mallewski/TaupunktLueftung/docs/1747229085418.jpg

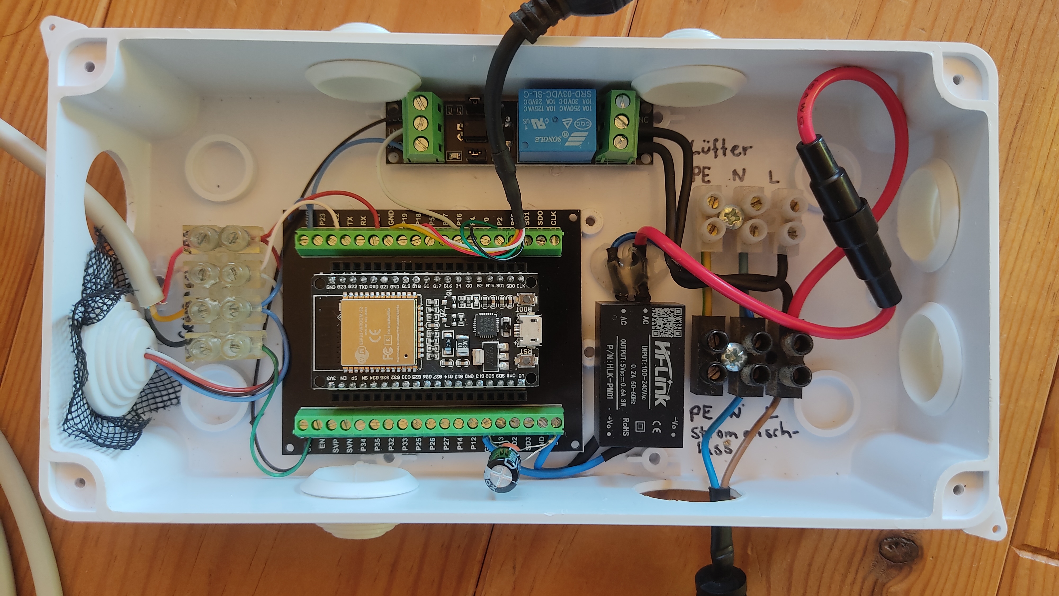
docs/1747229085418.jpg
