mallewski/TaupunktLueftung/(threads)

Thread 6 (2025-04-05):

Projektstruktur modularisieren für Plattform-Portierung

mallewski, 2025-04-05:
Ziel: Vorbereitung auf spätere Portierung des Projekts auf andere Plattformen wie z. B. ESP8266, ESP32-S3, Raspberry Pi Pico W etc. Trennung von Plattform-spezifischem Code, Webinterface & MQTT-Handling

Vorschläge für Refactoring / Modularisierung:

1. MQTT-Client abstrahieren (Interface / Wrapper)

Ziel: Plattformunabhängige MQTT-Schnittstelle

Aktuell stark an PubSubClient gebunden

Idee: Wrapper-Klasse MQTTClientWrapper o. ä.

z. B. mqtt.publish(topic, payload, retained)

mqtt.setCallback(fn)

Intern entscheidet die Klasse, ob PubSubClient o. ä. verwendet wird

Vorteil: Ersetzbar durch andere Bibliotheken (z. B. Async-MQTT, MQTT over TLS, etc.)

2. Webinterface auslagern

Trennung von Backend (Logik, Sensoren) und Frontend (HTML/CSS/JS)

Option A: HTML/JS in externe Dateien und über SPIFFS oder LittleFS laden

Option B: Web-UI komplett extern hosten (für Geräte ohne viel Speicher)

Vorteil:

kleinere Firmware

bessere Wartbarkeit (Frontend separat pflegbar)

evtl. Integration mit modernem JS-Tooling (Webpack, Vue, etc.)

3. Plattform-Checks einbauen

Makros wie #if defined(ESP8266) oder ARDUINO_ARCH_ESP32

Ziel: gezielte Hardware-Kompatibilität

Beispiel: unterschiedliche Pins, unterschiedliche Sensor-Ansteuerung

Langfristiges Ziel: "Plattform-Plugin-System"

Mögliche Klassenstruktur

class SensorManager {
  void begin();
  void readAll();
  float getTempInnen();
  float getHumidityAussen();
  ...
};

class MQTTManager {
  void connect();
  void publishDiscovery();
  void publishState(...);
  void loop();
};

Nutzen

Bessere Wartbarkeit

Einfachere Portierung auf andere Plattformen

Trennung von Verantwortlichkeiten (SRP – Single Responsibility Principle)

Zukunftssicheres Projekt für Langzeitpflege oder Open-Source-Veröffentlichung
