mallewski/TaupunktLueftung/TaupunktLueftung.ino

#include <Wire.h>
#include <WiFi.h>
#include <WebServer.h>
#include <Preferences.h>
#include <Adafruit_SHT31.h>
#include <PubSubClient.h>
#include <time.h>
#include <Update.h>
#include "secrets.h"
#include <WiFiManager.h>
#include <ESPmDNS.h>
#include <esp_netif.h> 
#include <esp_ota_ops.h>
#include <esp_partition.h>

struct Akkumulator;

// Explizite Forward-Declarations: Bei einer .ino-Datei dieser Größe mit
// mehreren großen Raw-String-Literalen (R"rawliteral(...)") für JS/CSS/HTML
// kann Arduinos automatische Prototyp-Erkennung (ctags-basiert, versteht
// Raw-Strings nicht wirklich) vereinzelt "durcheinanderkommen" und einzelne
// spätere Funktionsdefinitionen nicht mehr als solche erkennen. Explizite
// Deklarationen hier machen das unabhängig davon zuverlässig.
String getDashboardHtml();
String getSettingsHtml();
String getFirmwareModalHtml();
void prepareForFirmwareUpdate();

// DebugKategorie muss VOR den Funktionen bekannt sein, die sie als Parameter
// nutzen (debugKategorieAktiv/debugPush) - sonst scheitert Arduinos
// automatische Prototyp-Erkennung, da sie ihre Prototypen ganz oben in der
// Datei einfügt, an einer Stelle vor der eigentlichen enum-Definition weiter
// unten im Code.
enum DebugKategorie { KAT_SENSOR, KAT_MQTT, KAT_CHARTDATA, KAT_DIAG, KAT_AUTH };
bool debugKategorieAktiv(DebugKategorie kat);
void debugPush(DebugKategorie kat, String msg);

//Flash löschen !! löscht ALLE gespeicherten Daten im NVS (inkl. WiFi und Preferences)
//#define DEBUG_ERASE_NVS   // aktivieren zum Löschen des Flash/NVS 
#ifdef DEBUG_ERASE_NVS
#include "nvs_flash.h"
#endif

//Debugging
bool debugMQTT = false; // Debug für MQTT Discovery

//Parameter
#define NAME "TaupunktLueftung"
#define DEFAULT_HOSTNAME "TaupunktLueftung"
String hostname = DEFAULT_HOSTNAME;
#define FIRMWARE_VERSION "v4.3"

// Automatischer Cache-Buster für /style.css und /script.js, unabhängig von
// FIRMWARE_VERSION: __DATE__/__TIME__ sind Standard-C++-Makros, die der
// Compiler bei JEDEM Kompiliervorgang automatisch mit Datum/Uhrzeit des
// Builds füllt - dadurch ändert sich der Cache-Buster garantiert bei jedem
// einzelnen Flash, auch wenn FIRMWARE_VERSION mal vergessen wird
// hochzuzählen (wie zuletzt geschehen: CSS/JS blieben dadurch trotz
// geänderter Firmware im Browser-Cache hängen, u.a. Ursache für das
// beobachtete "Zeitraum springt zurück"-Verhalten).
#define BUILD_STAMP __DATE__ "-" __TIME__
#define RELAY_LED_PIN 16
#define STATUS_GREEN_PIN 2
#define STATUS_RED_PIN 18
#define STATUS_YELLOW_PIN 19
#define SENSORZYKLUS_MS 5000

//Frimware-Update
bool firmwareUpdateSuccess = false;
bool mqttAktivVorUpdate = false;
bool firmwareUploadAuthorized = false; // wird pro Upload-Request in UPLOAD_FILE_START gesetzt

//Umschaltung zwischen DHT22 (Pin17) und SHT31 für Sensor Außen
#define SENSOR_TYP_AUSSEN_SHT31  // auskommentieren für DHT22
#ifdef SENSOR_TYP_AUSSEN_SHT31
Adafruit_SHT31 shtAussen = Adafruit_SHT31();
#else
#include <DHT.h>
#define DHTPIN 17
#define DHTTYPE DHT22
DHT dht(DHTPIN, DHTTYPE);
#endif

Preferences prefs;
WebServer server(80);
WiFiClient espClient;
PubSubClient mqttClient(espClient);
Adafruit_SHT31 shtInnen = Adafruit_SHT31();

char configUsername[32] = "admin"; // Default; über Einstellungen änderbar (dann in NVS gespeichert)
char configPassword[64] = CONFIG_PASSWORD; // Default aus secrets.h; über Einstellungen änderbar (dann in NVS gespeichert)

bool sensorFehlerInnen = false;
bool sensorFehlerAussen = false;
unsigned long sensorFehlerSeit = 0; // 0 = kein Fehler aktiv; Fail-Safe-Timer (kostet nur 4 Byte RAM)

// Wie lange darf ein Sensorfehler andauern, bevor die Lüftung zwangsweise
// abgeschaltet wird? Kurze Aussetzer (I2C-Hänger etc.) werden dank Re-Init
// in aktualisiereSensoren() meist schon im selben 5s-Zyklus behoben, daher
// reicht eine kurze Gnadenfrist, um unnötiges Relais-Takten zu vermeiden.
#define SENSOR_FAILSAFE_MS (15UL * 1000UL)

// Mindestabstand zwischen zwei automatischen MQTT-Verbindungsversuchen aus
// loop() heraus (handleMQTT()). Ohne diese Bremse würde reconnectMQTT() bei
// nicht erreichbarem Broker bei JEDEM loop()-Durchlauf erneut blockierend
// versuchen zu verbinden und dabei die Weboberfläche (server.handleClient()
// kommt in loop() erst danach dran) am Stück lahmlegen.
#define MQTT_RECONNECT_INTERVAL_MS 5000UL
unsigned long letzterMqttVersuch = 0;

char mqttServer[64] = "";     // leer oder z.B. "192.168.1.100"
int mqttPort = 1883;          // Standard-MQTT-Port
char mqttUser[32] = "";
char mqttPassword[64] = "";

String mqttTempInnen = "sensors/temp_innen";
String mqttHygroInnen = "sensors/hygro_innen";
String mqttTempAussen = "sensors/temp_aussen";
String mqttHygroAussen = "sensors/hygro_aussen";
String mqttPublishPrefix = "taupunktlueftung/";
String mqttDiscoveryPrefix = "homeassistant/";

bool mqttAktiv = false;
String modus_innen = "hardware";
String modus_aussen = "hardware";
bool updateModeActive = false;
bool schutzVorAuskuehlungAktiv = false;
bool schutzVorAustrocknungAktiv = false;
float minFeuchteInnen = 35.0; // Mindest-RH, z.B. 35 %
float minTempInnen = 12.0; // °C – Beispielwert
float taupunktDifferenzSchwellwert = 4.0;
unsigned long mindestLaufzeit_ms = 2 * 60 * 1000;
unsigned long mindestPause_ms = 5 * 60 * 1000;
unsigned long letzteAktivierung = 0;
unsigned long letzteDeaktivierung = 0;
bool konstanteFeuchteAktiv = false;
float zielFeuchteInnen = 45.0;
float hysterese = 2.0; // % RH

float t_in = NAN, rh_in = NAN, td_in = NAN;
float t_out = NAN, rh_out = NAN, td_out = NAN;

float mqtt_t_in = NAN, mqtt_rh_in = NAN;
float mqtt_t_out = NAN, mqtt_rh_out = NAN;

#define HIST_NULL INT16_MIN

int16_t toI16(float v) {
  if (isnan(v) || isinf(v)) return HIST_NULL;
  return (int16_t) round(v * 10.0);
}

// ===== Tier 1: 5s-Auflösung, 1 Stunde =====
#define TIER1_POINTS 720
int16_t t1_td_in[TIER1_POINTS], t1_td_out[TIER1_POINTS], t1_diff[TIER1_POINTS];
int16_t t1_rh_in[TIER1_POINTS], t1_rh_out[TIER1_POINTS];
bool    t1_status[TIER1_POINTS];
int     t1_index = 0;

// ===== Tier 2: 1min-Auflösung, 24 Stunden =====
#define TIER2_POINTS 1440
#define TIER2_INTERVAL_MS 60000UL
int16_t t2_td_in[TIER2_POINTS], t2_td_out[TIER2_POINTS];
int16_t t2_diff_avg[TIER2_POINTS], t2_diff_min[TIER2_POINTS], t2_diff_max[TIER2_POINTS];
int16_t t2_rh_in_avg[TIER2_POINTS], t2_rh_in_min[TIER2_POINTS], t2_rh_in_max[TIER2_POINTS];
int16_t t2_rh_out[TIER2_POINTS], t2_rh_out_min[TIER2_POINTS], t2_rh_out_max[TIER2_POINTS];
bool    t2_status[TIER2_POINTS];
int     t2_index = 0;
unsigned long t2_letzterEintrag = 0;

// ===== Tier 3: 1h-Auflösung, 30 Tage =====
#define TIER3_POINTS 720
#define TIER3_INTERVAL_MS 3600000UL
int16_t t3_td_in[TIER3_POINTS], t3_td_out[TIER3_POINTS];
int16_t t3_diff_avg[TIER3_POINTS], t3_diff_min[TIER3_POINTS], t3_diff_max[TIER3_POINTS];
int16_t t3_rh_in_avg[TIER3_POINTS], t3_rh_in_min[TIER3_POINTS], t3_rh_in_max[TIER3_POINTS];
int16_t t3_rh_out[TIER3_POINTS], t3_rh_out_min[TIER3_POINTS], t3_rh_out_max[TIER3_POINTS];
bool    t3_status[TIER3_POINTS];
int     t3_index = 0;
unsigned long t3_letzterEintrag = 0;

// ===== Akkumulatoren (bleiben float, für präzise Summierung) =====
struct Akkumulator {
  float summe_td_in = 0, summe_td_out = 0, summe_diff = 0;
  float min_diff = 999;
  float max_diff = -999; // wichtig für die positive Schwelle (diff >= Schwellwert schaltet die Lüftung ein);
                          // min_diff bleibt für die negative Schwelle (diff <= -Schwellwert, "Befeuchtend"-Anzeige)
  float summe_rh_in = 0, min_rh_in = 999, max_rh_in = -999;
  float summe_rh_out = 0, min_rh_out = 999, max_rh_out = -999;
  int anzahl = 0;
  bool warAktiv = false;
};
Akkumulator akkuTier2;
Akkumulator akkuTier3;

// ===== Debug-Log fürs Webinterface =====
// Ergänzt die bestehenden Serial-Ausgaben um einen kleinen Ringpuffer im RAM,
// der über die Einstellungsseite abrufbar ist - für Diagnose ohne USB-Kabel/
// seriellen Monitor griffbereit zu haben. Bewusst nur die Kategorien, die
// tatsächlich während einer laufenden Verbindung zum Webinterface auftreten
// können (Boot-Ablauf/WLAN-Verbindungsaufbau passiert VOR dem Start des
// Webservers und wäre dort ohnehin nie zu sehen). Enum-Definition (siehe oben
// bei den Forward-Declarations) und diese Variablen/Funktionen gehören
// zusammen, sind aber aus Compiler-Gründen getrennt.

bool debugModusAktiv = false;
bool debugKatSensor = false;
bool debugKatMqtt = false;
bool debugKatChartdata = false;
bool debugKatDiag = false;
bool debugKatAuth = false;

#define DEBUG_PUFFER_ZEILEN 60
String debugPuffer[DEBUG_PUFFER_ZEILEN];
int debugPufferIndex = 0;
int debugPufferAnzahl = 0; // wie viele Zeilen tatsächlich befüllt sind (< DEBUG_PUFFER_ZEILEN direkt nach dem Boot)

bool debugKategorieAktiv(DebugKategorie kat) {
  if (!debugModusAktiv) return false;
  switch (kat) {
    case KAT_SENSOR:    return debugKatSensor;
    case KAT_MQTT:       return debugKatMqtt;
    case KAT_CHARTDATA: return debugKatChartdata;
    case KAT_DIAG:        return debugKatDiag;
    case KAT_AUTH:        return debugKatAuth;
  }
  return false;
}

// Schreibt zusätzlich zur ohnehin vorhandenen Serial-Ausgabe (unverändert an
// jeder bisherigen Stelle) in den Ringpuffer - aber NUR, wenn Debugmodus und
// die jeweilige Kategorie aktiv sind. So bleibt der kleine Puffer nicht sofort
// von einer einzelnen, sehr häufig feuernden Kategorie (z.B. chartdata)
// zugemüllt, wenn die eigentlich interessiert.
void debugPush(DebugKategorie kat, String msg) {
  if (!debugKategorieAktiv(kat)) return;
  debugPuffer[debugPufferIndex] = getUhrzeit() + " " + msg;
  debugPufferIndex = (debugPufferIndex + 1) % DEBUG_PUFFER_ZEILEN;
  if (debugPufferAnzahl < DEBUG_PUFFER_ZEILEN) debugPufferAnzahl++;
}


String statusText = "Unbekannt";
bool lueftungAktiv = false;
String logEintrag = "";
String letzteUhrzeit = "--:--:--";

String getUhrzeit() {
  struct tm timeinfo;
  if (!getLocalTime(&timeinfo)) return "--:--:--";
  char buf[20];
  strftime(buf, sizeof(buf), "%H:%M:%S", &timeinfo);
  return String(buf);
}

void logEvent(String msg) {
  letzteUhrzeit = getUhrzeit();
  logEintrag = letzteUhrzeit + " - " + msg;
  Serial.println(logEintrag);
}

void setLEDs(bool gruen, bool rot, bool gelb) {
  if (sensorFehlerInnen || sensorFehlerAussen) return; // Fehlerzustand: LEDs werden separat gesteuert
  digitalWrite(STATUS_GREEN_PIN, gruen);
  digitalWrite(STATUS_RED_PIN, rot);
  digitalWrite(STATUS_YELLOW_PIN, gelb);
}

//Taupunktberechnung
float berechneTaupunkt(float T, float RH) {
  float a = (T >= 0) ? 7.5 : 7.6;
  float b = (T >= 0) ? 237.3 : 240.7;
  float sdd = 6.1078 * pow(10, (a * T) / (b + T));
  float dd = sdd * RH / 100.0;
  float v = log10(dd / 6.1078);
  return (b * v) / (a - v);
}

void akkumuliere(Akkumulator &a, float ti, float to, float diff, float ri, float ro, bool aktiv) {
  a.summe_td_in += ti;
  a.summe_td_out += to;
  a.summe_diff += diff;
  a.min_diff = min(a.min_diff, diff);
  a.max_diff = max(a.max_diff, diff);
  a.summe_rh_in += ri;
  a.min_rh_in = min(a.min_rh_in, ri);
  a.max_rh_in = max(a.max_rh_in, ri);
  a.summe_rh_out += ro;
  a.min_rh_out = min(a.min_rh_out, ro);
  a.max_rh_out = max(a.max_rh_out, ro);
  a.anzahl++;
  if (aktiv) a.warAktiv = true;
}

void historieAktualisieren() {
  float diff = td_in - td_out;
  unsigned long jetzt = millis();

  t1_td_in[t1_index] = toI16(td_in);
  t1_td_out[t1_index] = toI16(td_out);
  t1_diff[t1_index] = toI16(diff);
  t1_rh_in[t1_index] = toI16(rh_in);
  t1_rh_out[t1_index] = toI16(rh_out);
  t1_status[t1_index] = lueftungAktiv;
  t1_index = (t1_index + 1) % TIER1_POINTS;

  akkumuliere(akkuTier2, td_in, td_out, diff, rh_in, rh_out, lueftungAktiv);

  if (jetzt - t2_letzterEintrag >= TIER2_INTERVAL_MS && akkuTier2.anzahl > 0) {
    t2_letzterEintrag = jetzt;
    float avg_ti = akkuTier2.summe_td_in / akkuTier2.anzahl;
    float avg_to = akkuTier2.summe_td_out / akkuTier2.anzahl;
    float avg_diff = akkuTier2.summe_diff / akkuTier2.anzahl;
    float avg_ri = akkuTier2.summe_rh_in / akkuTier2.anzahl;
    float avg_ro = akkuTier2.summe_rh_out / akkuTier2.anzahl;

    t2_td_in[t2_index] = toI16(avg_ti);
    t2_td_out[t2_index] = toI16(avg_to);
    t2_diff_avg[t2_index] = toI16(avg_diff);
    t2_diff_min[t2_index] = toI16(akkuTier2.min_diff);
    t2_diff_max[t2_index] = toI16(akkuTier2.max_diff);
    t2_rh_in_avg[t2_index] = toI16(avg_ri);
    t2_rh_in_min[t2_index] = toI16(akkuTier2.min_rh_in);
    t2_rh_in_max[t2_index] = toI16(akkuTier2.max_rh_in);
    t2_rh_out[t2_index] = toI16(avg_ro);
    t2_rh_out_min[t2_index] = toI16(akkuTier2.min_rh_out);
    t2_rh_out_max[t2_index] = toI16(akkuTier2.max_rh_out);
    t2_status[t2_index] = akkuTier2.warAktiv;
    t2_index = (t2_index + 1) % TIER2_POINTS;

    akkumuliere(akkuTier3, avg_ti, avg_to, avg_diff, avg_ri, avg_ro, akkuTier2.warAktiv);
    akkuTier3.min_diff = min(akkuTier3.min_diff, akkuTier2.min_diff);
    akkuTier3.max_diff = max(akkuTier3.max_diff, akkuTier2.max_diff);
    akkuTier3.min_rh_in = min(akkuTier3.min_rh_in, akkuTier2.min_rh_in);
    akkuTier3.max_rh_in = max(akkuTier3.max_rh_in, akkuTier2.max_rh_in);
    akkuTier3.min_rh_out = min(akkuTier3.min_rh_out, akkuTier2.min_rh_out);
    akkuTier3.max_rh_out = max(akkuTier3.max_rh_out, akkuTier2.max_rh_out);

    akkuTier2 = Akkumulator();

    if (jetzt - t3_letzterEintrag >= TIER3_INTERVAL_MS && akkuTier3.anzahl > 0) {
      t3_letzterEintrag = jetzt;
      t3_td_in[t3_index] = toI16(akkuTier3.summe_td_in / akkuTier3.anzahl);
      t3_td_out[t3_index] = toI16(akkuTier3.summe_td_out / akkuTier3.anzahl);
      t3_diff_avg[t3_index] = toI16(akkuTier3.summe_diff / akkuTier3.anzahl);
      t3_diff_min[t3_index] = toI16(akkuTier3.min_diff);
      t3_diff_max[t3_index] = toI16(akkuTier3.max_diff);
      t3_rh_in_avg[t3_index] = toI16(akkuTier3.summe_rh_in / akkuTier3.anzahl);
      t3_rh_in_min[t3_index] = toI16(akkuTier3.min_rh_in);
      t3_rh_in_max[t3_index] = toI16(akkuTier3.max_rh_in);
      t3_rh_out[t3_index] = toI16(akkuTier3.summe_rh_out / akkuTier3.anzahl);
      t3_rh_out_min[t3_index] = toI16(akkuTier3.min_rh_out);
      t3_rh_out_max[t3_index] = toI16(akkuTier3.max_rh_out);
      t3_status[t3_index] = akkuTier3.warAktiv;
      t3_index = (t3_index + 1) % TIER3_POINTS;
      akkuTier3 = Akkumulator();
    }
  }
}

void aktualisiereSensoren() {
  // Innen
  if (modus_innen == "mqtt" && mqttAktiv) {
    t_in = mqtt_t_in;
    rh_in = mqtt_rh_in;
  } else {
    t_in = shtInnen.readTemperature();
    rh_in = shtInnen.readHumidity();

    if (isnan(t_in) || isnan(rh_in)) {
      Serial.println("SHT31 innen liefert NAN – versuche Re-Init...");
      debugPush(KAT_SENSOR, "SHT31 innen liefert NAN – versuche Re-Init...");
      if (shtInnen.begin(0x44)) {
        delay(20);
        float temp = shtInnen.readTemperature();
        float hum = shtInnen.readHumidity();
        if (!isnan(temp) && !isnan(hum)) {
          t_in = temp;
          rh_in = hum;
          Serial.println("SHT31 innen Re-Init erfolgreich.");
          debugPush(KAT_SENSOR, "SHT31 innen Re-Init erfolgreich.");
        } else {
          Serial.println("SHT31 innen Re-Init fehlgeschlagen (Werte weiterhin NAN).");
          debugPush(KAT_SENSOR, "SHT31 innen Re-Init fehlgeschlagen (Werte weiterhin NAN).");
        }
      } else {
        Serial.println("SHT31 innen Re-Init fehlgeschlagen (begin() false).");
        debugPush(KAT_SENSOR, "SHT31 innen Re-Init fehlgeschlagen (begin() false).");
      }
    }
  }

#ifdef SENSOR_TYP_AUSSEN_SHT31
  // Außen – SHT31
  if (modus_aussen == "mqtt" && mqttAktiv) {
    t_out = mqtt_t_out;
    rh_out = mqtt_rh_out;
  } else {
    t_out = shtAussen.readTemperature();
    rh_out = shtAussen.readHumidity();

    if (isnan(t_out) || isnan(rh_out)) {
      Serial.println("SHT31 außen liefert NAN – versuche Re-Init...");
      debugPush(KAT_SENSOR, "SHT31 außen liefert NAN – versuche Re-Init...");
      if (shtAussen.begin(0x45)) {
        delay(20);
        t_out = shtAussen.readTemperature();
        rh_out = shtAussen.readHumidity();
        Serial.println("SHT31 außen Re-Init erfolgreich.");
        debugPush(KAT_SENSOR, "SHT31 außen Re-Init erfolgreich.");
      } else {
        Serial.println("SHT31 außen Re-Init fehlgeschlagen.");
        debugPush(KAT_SENSOR, "SHT31 außen Re-Init fehlgeschlagen.");
      }
    }
  }
#else
  // Außen – DHT22
  if (modus_aussen == "mqtt" && mqttAktiv) {
    t_out = mqtt_t_out;
    rh_out = mqtt_rh_out;
  } else {
    t_out = dht.readTemperature();
    rh_out = dht.readHumidity();

    if (isnan(t_out) || isnan(rh_out)) {
      Serial.println("DHT22 liefert NAN – versuche Re-Init...");
      debugPush(KAT_SENSOR, "DHT22 liefert NAN – versuche Re-Init...");
      dht.begin();
      delay(100);
      float temp = dht.readTemperature();
      float hum = dht.readHumidity();
      if (!isnan(temp) && !isnan(hum)) {
        t_out = temp;
        rh_out = hum;
        Serial.println("DHT22 Re-Init erfolgreich.");
        debugPush(KAT_SENSOR, "DHT22 Re-Init erfolgreich.");
      } else {
        Serial.println("DHT22 Re-Init fehlgeschlagen (Werte weiterhin NAN).");
        debugPush(KAT_SENSOR, "DHT22 Re-Init fehlgeschlagen (Werte weiterhin NAN).");
      }
    }
  }
#endif

  // Fehlerstatus getrennt prüfen
  sensorFehlerInnen = isnan(t_in) || isnan(rh_in);
  sensorFehlerAussen = isnan(t_out) || isnan(rh_out);

  if (sensorFehlerInnen) {
    td_in = NAN;
    Serial.println("Sensorfehler INNEN erkannt!");
    debugPush(KAT_SENSOR, "Sensorfehler INNEN erkannt!");
  } else {
    td_in = berechneTaupunkt(t_in, rh_in);
  }

  if (sensorFehlerAussen) {
    td_out = NAN;
    Serial.println("Sensorfehler AUSSEN erkannt!");
    debugPush(KAT_SENSOR, "Sensorfehler AUSSEN erkannt!");
  } else {
    td_out = berechneTaupunkt(t_out, rh_out);
  }

  publishAllStates();
}

void steuerlogik() {
  unsigned long jetzt = millis();

  // === 0. Fail-Safe bei Sensorausfall ===
  if (isnan(td_in) || isnan(td_out) || isnan(rh_in) || isnan(t_in)) {
    if (sensorFehlerSeit == 0) sensorFehlerSeit = jetzt;

    if (jetzt - sensorFehlerSeit >= SENSOR_FAILSAFE_MS) {
      if (lueftungAktiv) {
        digitalWrite(RELAY_LED_PIN, LOW);
        lueftungAktiv = false;
        letzteDeaktivierung = jetzt;
        logEvent("Lüftung zwangsweise deaktiviert - Sensorfehler (Fail-Safe)");
      }
      statusText = "Sensorfehler - Lüftung aus (Fail-Safe)";
    } else {
      statusText = "Sensorfehler - warte auf Fail-Safe-Abschaltung";
    }

    historieAktualisieren();
    publishAllStates();
    return;
  }
  sensorFehlerSeit = 0;

  float diff = td_in - td_out;

  // === 1. Austrocknungsschutz ===
  if (schutzVorAustrocknungAktiv && rh_in < minFeuchteInnen) {
    if (lueftungAktiv) {
      digitalWrite(RELAY_LED_PIN, LOW);
      lueftungAktiv = false;
      letzteDeaktivierung = jetzt;
      logEvent("Lüftung deaktiviert – Austrocknungsschutz");
    }
    setLEDs(false, false, true);
    statusText = "Austrocknungsschutz – Lüftung aus";
    historieAktualisieren();  
    publishAllStates();
    return;
  }

  // === 2. Temperaturschutz ===
  if (schutzVorAuskuehlungAktiv && t_in < minTempInnen) {
    if (lueftungAktiv) {
      digitalWrite(RELAY_LED_PIN, LOW);
      lueftungAktiv = false;
      letzteDeaktivierung = jetzt;
      logEvent("Lüftung deaktiviert – Temperaturschutz");
    }
    setLEDs(false, false, true);
    statusText = "Temperaturschutz – Lüftung aus";
    historieAktualisieren();  
    publishAllStates();
    return;
  }

  // === 3. Feuchteregelung aktiv? ===
  if (konstanteFeuchteAktiv) {
    float rhSoll_min = zielFeuchteInnen - hysterese;
    float rhSoll_max = zielFeuchteInnen + hysterese;

    if (rh_in < rhSoll_min && td_out > td_in + 1.0) {
      digitalWrite(RELAY_LED_PIN, HIGH);
      if (!lueftungAktiv) {
        letzteAktivierung = jetzt;
        logEvent("Lüftung aktiviert – Befeuchtung (Regelung)");
      }
      lueftungAktiv = true;
      setLEDs(false, true, false);
      statusText = "Regelung: Befeuchten (Lüftung AN)";
    } 
    else if (rh_in > rhSoll_max && td_out < td_in - 1.0) {
      digitalWrite(RELAY_LED_PIN, HIGH);
      if (!lueftungAktiv) {
        letzteAktivierung = jetzt;
        logEvent("Lüftung aktiviert – Entfeuchtung (Regelung)");
      }
      lueftungAktiv = true;
      setLEDs(true, false, false);
      statusText = "Regelung: Entfeuchten (Lüftung AN)";
    } 
    else {
      if (lueftungAktiv) {
        digitalWrite(RELAY_LED_PIN, LOW);
        letzteDeaktivierung = jetzt;
        logEvent("Lüftung deaktiviert – RH im Zielbereich");
      }
      lueftungAktiv = false;
      setLEDs(false, false, true);
      statusText = "Regelung: RH im Zielbereich – Lüftung AUS";
    }

    historieAktualisieren();
    publishAllStates();
    return;
  }

  // === 4. Klassische Taupunktlogik ===
  bool darfEinschalten = (diff >= taupunktDifferenzSchwellwert) &&
                         (!lueftungAktiv) &&
                         (jetzt - letzteDeaktivierung >= mindestPause_ms);

  bool darfAusschalten = (diff < taupunktDifferenzSchwellwert) &&
                         (lueftungAktiv) &&
                         (jetzt - letzteAktivierung >= mindestLaufzeit_ms);

  if (darfEinschalten) {
    digitalWrite(RELAY_LED_PIN, HIGH);
    lueftungAktiv = true;
    letzteAktivierung = jetzt;
    logEvent("Lüftung aktiviert (Taupunktdifferenz)");
  }

  if (darfAusschalten) {
    digitalWrite(RELAY_LED_PIN, LOW);
    lueftungAktiv = false;
    letzteDeaktivierung = jetzt;
    logEvent("Lüftung deaktiviert (Taupunktdifferenz)");
  }

  if (lueftungAktiv) {
    setLEDs(true, false, false);
    statusText = "Trocknend – Lüftung aktiv";
  } else if (diff <= -taupunktDifferenzSchwellwert) {
    setLEDs(false, true, false);
    statusText = "Befeuchtend – Lüftung aus";
  } else {
    setLEDs(false, false, true);
    statusText = "Neutral – Lüftung aus";
  }

  historieAktualisieren();
  publishAllStates();
}

//MQTT Empfang
void mqttCallback(char* topic, byte* payload, unsigned int length) {
  String val;
  for (unsigned int i = 0; i < length; i++) val += (char)payload[i];
  Serial.println("MQTT RX: topic='" + String(topic) + "' payload='" + val + "'");
  debugPush(KAT_MQTT, "MQTT RX: topic='" + String(topic) + "' payload='" + val + "'");
  Serial.println("Erwartet mqttTempInnen='" + mqttTempInnen + "'");
  float fval = val.toFloat();
  if (String(topic) == mqttTempInnen) mqtt_t_in = fval;
  if (String(topic) == mqttHygroInnen) mqtt_rh_in = fval;
  if (String(topic) == mqttTempAussen) mqtt_t_out = fval;
  if (String(topic) == mqttHygroAussen) mqtt_rh_out = fval;
}

//MQTT Senden
void publishAllStates() {
  if (!mqttAktiv || !mqttClient.connected()) return;

  mqttClient.publish((mqttPublishPrefix + "temp_innen").c_str(), String(t_in, 1).c_str(), true);
  mqttClient.publish((mqttPublishPrefix + "hygro_innen").c_str(), String(rh_in, 1).c_str(), true);
  mqttClient.publish((mqttPublishPrefix + "taupunkt_innen").c_str(), String(td_in, 1).c_str(), true);

  mqttClient.publish((mqttPublishPrefix + "temp_aussen").c_str(), String(t_out, 1).c_str(), true);
  mqttClient.publish((mqttPublishPrefix + "hygro_aussen").c_str(), String(rh_out, 1).c_str(), true);
  mqttClient.publish((mqttPublishPrefix + "taupunkt_aussen").c_str(), String(td_out, 1).c_str(), true);

  mqttClient.publish((mqttPublishPrefix + "diff").c_str(), String(td_in - td_out, 1).c_str(), true);

  mqttClient.publish((mqttPublishPrefix + "status").c_str(), lueftungAktiv ? "1" : "0", true);

  mqttClient.publish((mqttPublishPrefix + "availability").c_str(), "online", true);

  mqttClient.publish((mqttPublishPrefix + "fehler_innen").c_str(), sensorFehlerInnen ? "1" : "0", true);
  mqttClient.publish((mqttPublishPrefix + "fehler_aussen").c_str(), sensorFehlerAussen ? "1" : "0", true);
}

void publishMQTTDiscovery() {
  if (!mqttClient.connected()) return;
  String deviceID = hostname;

  struct Sensor {
    String id;
    String name;
    String unit;
    String devclass;
    String topic;
    bool binary;
  };

  Sensor sensoren[] = {
    {"tin", "Temperatur Innen", "°C", "temperature", mqttPublishPrefix + "temp_innen", false},
    {"hin", "Luftfeuchte Innen", "%", "humidity", mqttPublishPrefix + "hygro_innen", false},
    {"tdin", "Taupunkt Innen", "°C", "temperature", mqttPublishPrefix + "taupunkt_innen", false},
    {"tout", "Temperatur Außen", "°C", "temperature", mqttPublishPrefix + "temp_aussen", false},
    {"hout", "Luftfeuchte Außen", "%", "humidity", mqttPublishPrefix + "hygro_aussen", false},
    {"tdout", "Taupunkt Außen", "°C", "temperature", mqttPublishPrefix + "taupunkt_aussen", false},
    {"diff", "Taupunkt-Differenz", "°C", "temperature", mqttPublishPrefix + "diff", false},
    {"lueftung", "Lüftung aktiv", "", "", mqttPublishPrefix + "status", true},
    {"fehler_innen", "Sensorfehler Innen", "", "", mqttPublishPrefix + "fehler_innen", true},
    {"fehler_aussen", "Sensorfehler Außen", "", "", mqttPublishPrefix + "fehler_aussen", true}
  };

  for (Sensor s : sensoren) {
    String type = s.binary ? "binary_sensor" : "sensor";
    String configTopic = mqttDiscoveryPrefix + type + "/" + deviceID + "_" + s.id + "/config";

    String payload = "{";
    payload += "\"name\":\"" + s.name + "\",";
    payload += "\"state_topic\":\"" + s.topic + "\",";
    payload += "\"availability_topic\":\"" + mqttPublishPrefix + "availability\",";
    payload += "\"payload_available\":\"online\",\"payload_not_available\":\"offline\",";
    if (!s.unit.isEmpty()) payload += "\"unit_of_measurement\":\"" + s.unit + "\",";
    if (!s.devclass.isEmpty()) payload += "\"device_class\":\"" + s.devclass + "\",";
    if (s.binary) payload += "\"payload_on\":\"1\",\"payload_off\":\"0\",";
    payload += "\"unique_id\":\"" + deviceID + "_" + s.id + "\",";
    payload += "\"device\":{";
    payload += "\"identifiers\":[\"" + deviceID + "\"],";
    payload += "\"name\":\"TaupunktLueftung\",";
    payload += "\"model\":\"ESP32\",";
    payload += "\"manufacturer\":\"DIY\"}";
    payload += "}";
    bool ok = mqttClient.publish(configTopic.c_str(), payload.c_str(), true);
    if (debugMQTT) {
      Serial.println("Sende Discovery an Topic: " + configTopic);
      Serial.println("Payload: " + payload);
      Serial.println(ok ? "Publish erfolgreich" : "Publish FEHLGESCHLAGEN");
    }
  }
  if (debugMQTT) {
    mqttClient.publish("homeassistant/sensor/testsensor/config", 
    "{\"name\":\"TestSensor\",\"state_topic\":\"testsensor/value\",\"unit_of_measurement\":\"°C\",\"device_class\":\"temperature\"}", 
    true);
    mqttClient.publish("testsensor/value", "22.1", true);
  }
}

void loadMQTTSettings() {
  prefs.begin("config", true);
  String serverStr = prefs.getString("mqtt_server", mqttServer);
  String user = prefs.getString("mqtt_user", mqttUser);
  String pass = prefs.getString("mqtt_pass", mqttPassword);
  mqttPort = prefs.getInt("mqtt_port", mqttPort);
  prefs.end();

  serverStr.toCharArray(mqttServer, sizeof(mqttServer));
  user.toCharArray(mqttUser, sizeof(mqttUser));
  pass.toCharArray(mqttPassword, sizeof(mqttPassword));
  mqttClient.setServer(mqttServer, mqttPort);
}

void saveMQTTSettings() {
  prefs.begin("config", false);
  prefs.putString("mqtt_server", mqttServer);
  prefs.putInt("mqtt_port", mqttPort);
  prefs.putString("mqtt_user", mqttUser);
  prefs.putString("mqtt_pass", mqttPassword);
  prefs.end();
}

void loadMQTTTopics() {
  prefs.begin("config", true);
  mqttTempInnen = prefs.getString("mqtt_temp_in", mqttTempInnen);
  mqttHygroInnen = prefs.getString("mqtt_rh_in", mqttHygroInnen);
  mqttTempAussen = prefs.getString("mqtt_temp_out", mqttTempAussen);
  mqttHygroAussen = prefs.getString("mqtt_rh_out", mqttHygroAussen);
  mqttPublishPrefix = prefs.getString("mqtt_pub_prefix", mqttPublishPrefix);
  mqttDiscoveryPrefix = prefs.getString("mqtt_discovery_prefix", mqttDiscoveryPrefix);
  prefs.end();
}

void saveMQTTTopics() {
  prefs.begin("config", false);
  prefs.putString("mqtt_temp_in", mqttTempInnen);
  prefs.putString("mqtt_rh_in", mqttHygroInnen);
  prefs.putString("mqtt_temp_out", mqttTempAussen);
  prefs.putString("mqtt_rh_out", mqttHygroAussen);
  prefs.putString("mqtt_pub_prefix", mqttPublishPrefix);
  prefs.putString("mqtt_discovery_prefix", mqttDiscoveryPrefix);
  prefs.end();
}

void resubscribeMQTTTopics() {
  if (!mqttClient.connected()) return;
  mqttClient.subscribe(mqttTempInnen.c_str());
  mqttClient.subscribe(mqttHygroInnen.c_str());
  mqttClient.subscribe(mqttTempAussen.c_str());
  mqttClient.subscribe(mqttHygroAussen.c_str());
}

void reconnectMQTT() {
  if (!mqttAktiv) return;
  letzterMqttVersuch = millis(); // auch bei manuellem Aufruf (Config speichern, MQTT-Toggle)
                                  // mitzählen, damit direkt danach kein doppelter Auto-Versuch folgt
  while (!mqttClient.connected()) {
    Serial.print("MQTT verbinden mit: "); Serial.println(mqttServer);
    debugPush(KAT_MQTT, "MQTT verbinden mit: " + String(mqttServer));
    if (mqttClient.connect(NAME, mqttUser, mqttPassword, (mqttPublishPrefix + "availability").c_str(), 1, true, "offline" )) {
      delay(500);
      resubscribeMQTTTopics();
      Serial.println("MQTT verbunden.");
      debugPush(KAT_MQTT, "MQTT verbunden.");
      delay(500);
      publishMQTTDiscovery();
      mqttClient.publish("homeassistant/status", "online", true);
      mqttClient.publish((mqttPublishPrefix + "availability").c_str(), "online", true);
    } else {
      Serial.print("MQTT-Verbindung fehlgeschlagen. Code: ");
      Serial.println(mqttClient.state());
      debugPush(KAT_MQTT, "MQTT-Verbindung fehlgeschlagen. Code: " + String(mqttClient.state()));
      break;
    }
  }
  publishAllStates();
}

void handleChartData() {
  // Zeitmessung + Heap-Status für den seriellen Log: damit beim nächsten
  // Auftreten einer langsamen/fehlgeschlagenen Anfrage echte Werte vorliegen,
  // statt weiter zu vermuten, wo die Zeit hingeht.
  unsigned long tStart = millis();
  uint32_t heapVorher = ESP.getFreeHeap();

  String tier = server.hasArg("tier") ? server.arg("tier") : "1";
  // Wie viele der neuesten Punkte tatsächlich gebraucht werden - ohne diesen
  // Parameter (Rückwärtskompatibilität) wird wie bisher der komplette
  // Tier-Puffer gesendet. Vermeidet, dass z.B. für "10 Minuten" trotzdem der
  // komplette 1h-Tier1-Puffer (720 Punkte) übertragen wird, obwohl nur ein
  // Bruchteil davon dargestellt wird - spart sowohl Erzeugungszeit auf dem
  // ESP32 als auch Übertragungszeit übers WLAN.
  int angefordert = server.hasArg("count") ? server.arg("count").toInt() : -1;
  auto f2 = [](int16_t v) {
    return v == HIST_NULL ? String("null") : String(v / 10.0, 1);
  };

  server.setContentLength(CONTENT_LENGTH_UNKNOWN);
  server.send(200, "application/json", "");
  server.sendContent("[");

  int gesendetePunkte = 0;
  int gesendeteBloecke = 0;

  auto sendeTier = [&](int16_t* ti, int16_t* to, int16_t* davg, int16_t* dmin, int16_t* dmax,
                        int16_t* riavg, int16_t* rimin, int16_t* rimax, int16_t* ro, int16_t* romin, int16_t* romax, bool* st, int n, int startIdx) {
    int anzahl = (angefordert > 0 && angefordert < n) ? angefordert : n;
    int versatz = n - anzahl; // Startpunkt so weit nach vorn verschieben, dass nur die letzten "anzahl" Punkte drankommen
    gesendetePunkte = anzahl;

    // Mehrere Punkte zu einem Block bündeln, bevor tatsächlich gesendet wird:
    // Vorher löste JEDER einzelne Punkt einen eigenen server.sendContent()-Aufruf
    // aus - bei bis zu 1440 Punkten also 1440 einzelne TCP-Sendevorgänge mit
    // jeweils vollem Protokoll-Overhead für nur ~135 Bytes Nutzdaten. Das war
    // der Hauptgrund für die spürbar lange Ladezeit. Gleiche Datenmenge,
    // deutlich weniger Einzel-Sendevorgänge.
    const int BLOCK_GROESSE = 40;
    String block = "";
    block.reserve(BLOCK_GROESSE * 170); // vermeidet wiederholtes Nachvergrößern des Blocks selbst

    for (int i = 0; i < anzahl; i++) {
      int idx = (startIdx + versatz + i) % n;
      if (i > 0) block += ",";
      block += "{\"td_in\":" + f2(ti[idx]) + ",\"td_out\":" + f2(to[idx]) + ",";
      block += "\"diff\":" + f2(davg[idx]) + ",\"diff_min\":" + f2(dmin[idx]) + ",\"diff_max\":" + f2(dmax[idx]) + ",";
      block += "\"rh_in\":" + f2(riavg[idx]) + ",\"rh_in_min\":" + f2(rimin[idx]) + ",\"rh_in_max\":" + f2(rimax[idx]) + ",";
      block += "\"rh_out\":" + f2(ro[idx]) + ",\"rh_out_min\":" + f2(romin[idx]) + ",\"rh_out_max\":" + f2(romax[idx]) + ",";
      block += "\"status\":" + String(st[idx] ? 1 : 0) + "}";

      if ((i + 1) % BLOCK_GROESSE == 0 || i == anzahl - 1) {
        server.sendContent(block);
        gesendeteBloecke++;
        block = "";
      }
    }
  };

  if (tier == "2") {
    sendeTier(t2_td_in, t2_td_out, t2_diff_avg, t2_diff_min, t2_diff_max, t2_rh_in_avg, t2_rh_in_min, t2_rh_in_max, t2_rh_out, t2_rh_out_min, t2_rh_out_max, t2_status, TIER2_POINTS, t2_index);
  } else if (tier == "3") {
    sendeTier(t3_td_in, t3_td_out, t3_diff_avg, t3_diff_min, t3_diff_max, t3_rh_in_avg, t3_rh_in_min, t3_rh_in_max, t3_rh_out, t3_rh_out_min, t3_rh_out_max, t3_status, TIER3_POINTS, t3_index);
  } else {
    sendeTier(t1_td_in, t1_td_out, t1_diff, t1_diff, t1_diff, t1_rh_in, t1_rh_in, t1_rh_in, t1_rh_out, t1_rh_out, t1_rh_out, t1_status, TIER1_POINTS, t1_index);
  }

  server.sendContent("]");
  server.sendContent("");

  unsigned long dauerMs = millis() - tStart;
  uint32_t heapNachher = ESP.getFreeHeap();
  int32_t heapDiff = (int32_t)heapNachher - (int32_t)heapVorher;
  Serial.printf("[chartdata] tier=%s count=%d Punkte=%d Bloecke=%d Dauer=%lums FreeHeap vorher=%u nachher=%u Diff=%d\n",
                tier.c_str(), angefordert, gesendetePunkte, gesendeteBloecke, dauerMs, heapVorher, heapNachher, heapDiff);
  debugPush(KAT_CHARTDATA, "tier=" + tier + " count=" + String(angefordert) + " Punkte=" + String(gesendetePunkte) +
            " Bloecke=" + String(gesendeteBloecke) + " Dauer=" + String(dauerMs) + "ms Heap-Diff=" + String(heapDiff));
}

void handleLiveData() {
  String sichereUhrzeit = getUhrzeit();
  sichereUhrzeit.replace("\"", "'");
  String sichererStatus = statusText;
  sichererStatus.replace("\"", "'");

  unsigned long now = millis();
  String timerInfo = "";

  if (!lueftungAktiv && now - letzteDeaktivierung < mindestPause_ms) {
    unsigned long remaining = (mindestPause_ms - (now - letzteDeaktivierung)) / 1000;
    char buffer[6];
    snprintf(buffer, sizeof(buffer), "%lu:%02lu", remaining / 60, remaining % 60);
    timerInfo = String(buffer) + " min Sperre";
  } else if (lueftungAktiv && now - letzteAktivierung < mindestLaufzeit_ms) {
    unsigned long remaining = (mindestLaufzeit_ms - (now - letzteAktivierung)) / 1000;
    char buffer[6];
    snprintf(buffer, sizeof(buffer), "%lu:%02lu", remaining / 60, remaining % 60);
    timerInfo = String(buffer) + " min Mindestlaufzeit";
  }

  auto f1 = [](float val) {
    return isnan(val) || isinf(val) ? "null" : String(val, 1);
  };

  String json = "{";
  json += "\"t_in\":" + f1(t_in) + ",";
  json += "\"rh_in\":" + f1(rh_in) + ",";
  json += "\"t_out\":" + f1(t_out) + ",";
  json += "\"rh_out\":" + f1(rh_out) + ",";
  json += "\"td_in\":" + f1(td_in) + ",";
  json += "\"td_out\":" + f1(td_out) + ",";
  json += "\"zeit\":\"" + sichereUhrzeit + "\",";
  json += "\"status\":\"" + sichererStatus + "\",";
  json += "\"timer\":\"" + timerInfo + "\",";
  json += "\"schwelle\":" + String(taupunktDifferenzSchwellwert, 1) + ",";
  json += "\"feuchteregelungAktiv\":" + String(konstanteFeuchteAktiv ? "true" : "false") + ",";
  json += "\"zielRh\":" + String(zielFeuchteInnen, 1) + ",";
  json += "\"hysterese\":" + String(hysterese, 1);
  json += "}";
  server.send(200, "application/json", json);
}

void redirectToSettings() {
  server.send(200, "text/html", R"rawliteral(
    <html><head><meta charset='UTF-8'>
      <script>
        localStorage.setItem("stayOnSettings", "true");
        window.location.href = "/";
      </script>
    </head><body></body></html>
  )rawliteral");
}

void handleReboot() {
  server.send(200, "text/plain", "Neustart wird durchgeführt...");
  Serial.println("Neustart über Weboberfläche ausgelöst");
  delay(500);
  ESP.restart();
}

void handleWifiReset() {
  server.send(200, "text/plain", "WLAN-Zugangsdaten werden gelöscht, Gerät startet neu...");
  Serial.println("WLAN-Reset über Weboberfläche ausgelöst");
  delay(500);

  WiFiManager wm;
  wm.resetSettings();
  ESP.restart();
}

bool requireAuth() {
  if (!server.authenticate(configUsername, configPassword)) {
    // Nur echte Fehlversuche loggen (Client hat Zugangsdaten mitgeschickt,
    // die aber falsch waren) - nicht die ganz normale allererste Anfrage
    // eines Browsers ohne Authorization-Header, die jeder Seitenaufruf ohne
    // gespeicherte Zugangsdaten zwangsläufig einmal auslöst.
    if (server.hasHeader("Authorization")) {
      debugPush(KAT_AUTH, "Fehlgeschlagener Login-Versuch von " + server.client().remoteIP().toString());
    }
    server.requestAuthentication(BASIC_AUTH, "TaupunktLueftung");
    return false;
  }
  return true;
}

// --- Dashboard --->
// Reines JavaScript (keine <script>-Tags mehr drumherum!): wird über die
// eigene Route /script.js ausgeliefert (siehe handleScriptJS()), statt wie
// früher bei jedem Seitenaufruf komplett inline in handleRoot() eingebettet
// zu werden. Dadurch kann der Browser die Datei cachen (Cache-Control-Header
// in handleScriptJS()) und muss die ca. 20 KB nicht bei jedem Laden neu vom
// ESP32 anfordern - das war der Hauptgrund für die zuletzt spürbar langsamer
// gewordenen Seitenaufrufe.
const char MAIN_SCRIPT_JS[] PROGMEM = R"rawliteral(
      let SCHWELLWERT = 4.0;
      let FEUCHTEREGELUNG_AKTIV = false;
      let ZIEL_RH = 45.0;
      let HYSTERESE = 2.0;
      const COLOR_TD_IN = 'green';
      const COLOR_TD_OUT = 'blue';
      const COLOR_DIFF = 'orange';
      const COLOR_SCHWELL = 'gray';
      const COLOR_STATUS_ON = 'rgba(0,200,0,0.6)';
      const COLOR_STATUS_OFF = 'rgba(0,0,0,0)';
      let chart, chart_humidity, chart_status;
      let chartInitialized = false;

      function getIntervalInSeconds(tier) {
        if (tier === '1') return 5;    // Tier 1: 5 Sekunden
        if (tier === '2') return 60;   // Tier 2: 1 Minute
        if (tier === '3') return 3600; // Tier 3: 1 Stunde
        return 1;
      }
      function formatTime(date, tier) {
        if (tier === '3') {
          return `${String(date.getDate()).padStart(2, '0')}.${String(date.getMonth() + 1).padStart(2, '0')}. ${String(date.getHours()).padStart(2, '0')}:00`;
        } else if (tier === '2') {
          return `${String(date.getHours()).padStart(2, '0')}:${String(date.getMinutes()).padStart(2, '0')}`;
        } else {
          return `${String(date.getHours()).padStart(2, '0')}:${String(date.getMinutes()).padStart(2, '0')}:${String(date.getSeconds()).padStart(2, '0')}`;
        }
      }

      // Maximale Punktzahl, die tatsächlich sinnvoll auf einem Mobil-Bildschirm
      // unterscheidbar ist. Deutlich unter der Pixelbreite eines Telefon-Displays,
      // damit nie mehr als ein Punkt pro Pixel gezeichnet wird.
      const MAX_CHART_POINTS = 300;

      // Verdichtet für die Anzeige weiter, falls mehr Rohpunkte vorliegen, als
      // sinnvoll darstellbar sind - genau nach demselben Prinzip wie die
      // Tier2/Tier3-Speicherung auf dem Gerät selbst (Durchschnitt der
      // Durchschnitte, aber Minimum der Minima / Maximum der Maxima). Das ist
      // rein clientseitig zur Laufzeit, ändert nichts an den gespeicherten
      // Rohdaten auf dem ESP32, und verliert dabei nachweislich KEINEN
      // Extremwert - egal wie oft man diese Verdichtung verschachtelt, bleibt
      // das globale Minimum/Maximum exakt erhalten. Das behebt das "wilde
      // Zickzack" bei sehr vielen Punkten (z.B. 1440 Tier2-Punkte in der
      // 24h-Ansicht), ohne die zugrunde liegende Datenbasis zu verändern.
      function verdichteFuerAnzeige(punkte, effektivesIntervallSek) {
        if (punkte.length <= MAX_CHART_POINTS) {
          return { data: punkte, intervallSek: effektivesIntervallSek };
        }
        const bucketGroesse = Math.ceil(punkte.length / MAX_CHART_POINTS);
        const avg = (bucket, feld) => {
          const werte = bucket.map(p => p[feld]).filter(v => v !== null && v !== undefined);
          return werte.length ? werte.reduce((a, b) => a + b, 0) / werte.length : null;
        };
        const minVon = (bucket, feld) => {
          const werte = bucket.map(p => p[feld]).filter(v => v !== null && v !== undefined);
          return werte.length ? Math.min(...werte) : null;
        };
        const maxVon = (bucket, feld) => {
          const werte = bucket.map(p => p[feld]).filter(v => v !== null && v !== undefined);
          return werte.length ? Math.max(...werte) : null;
        };
        const verdichtet = [];
        for (let i = 0; i < punkte.length; i += bucketGroesse) {
          const bucket = punkte.slice(i, i + bucketGroesse);
          verdichtet.push({
            td_in: avg(bucket, 'td_in'),
            td_out: avg(bucket, 'td_out'),
            diff: avg(bucket, 'diff'),
            diff_min: minVon(bucket, 'diff_min'),
            diff_max: maxVon(bucket, 'diff_max'),
            rh_in: avg(bucket, 'rh_in'),
            rh_in_min: minVon(bucket, 'rh_in_min'),
            rh_in_max: maxVon(bucket, 'rh_in_max'),
            rh_out: avg(bucket, 'rh_out'),
            rh_out_min: minVon(bucket, 'rh_out_min'),
            rh_out_max: maxVon(bucket, 'rh_out_max'),
            status: bucket.some(p => p.status === 1) ? 1 : 0
          });
        }
        return { data: verdichtet, intervallSek: effektivesIntervallSek * bucketGroesse };
      }

      // Wie oft sich die aktuell ausgewählte Zeitspanne überhaupt sinnvoll neu
      // laden muss: Tier 1 (Rohdaten) ändert sich alle 5s, Tier 2 (Minuten-
      // Mittelwerte) nur einmal pro Minute, Tier 3 (Stunden-Mittelwerte) nur
      // einmal pro Stunde. Bisher lief IMMER ein 5s-Intervall, wodurch z.B.
      // die 24h-Ansicht den kompletten (~194 KB großen) Datensatz zwölfmal
      // öfter neu abgerufen und geparst hat, als sich die Daten überhaupt
      // ändern - unnötig langsam, und auf leistungsschwächeren Mobilgeräten
      // (weniger CPU/RAM als ein Desktop-Browser) mit der Zeit spürbar
      // störend, da die Garbage Collection dem wiederholten Verarbeiten
      // großer JSON-Antworten hinterherhinkt.
      function getChartRefreshIntervalMs(tier) {
        if (tier === '2') return 60000;   // 1 Minute
        if (tier === '3') return 300000;  // 5 Minuten (Daten ändern sich nur stündlich)
        return 5000;                      // Tier 1: echte 5s-Rohdaten
      }

      function scheduleChartRefresh() {
        // Eventuell noch laufenden, mit dem ALTEN Takt geplanten Timer
        // verwerfen - sonst würde ein manueller Wechsel auf eine schnellere
        // Zeitspanne (z.B. von "30 Tage" auf "1 Stunde") bis zu 5 Minuten
        // brauchen, bis der Hintergrund-Refresh den neuen, schnelleren Takt
        // übernimmt. Die ID wird bewusst als Eigenschaft an der Funktion
        // selbst gespeichert (wie schon bei openFirmwareModalUI.listenerAdded)
        // statt in einer neuen globalen Variable direkt vor dieser Funktion -
        // das hat zuvor Arduinos automatische Prototyp-Erkennung durcheinandergebracht.
        if (scheduleChartRefresh.timeoutId) clearTimeout(scheduleChartRefresh.timeoutId);

        const [, tier] = document.getElementById('rangeSelector').value.split('|');
        scheduleChartRefresh.timeoutId = setTimeout(async () => {
          await updateChart();
          scheduleChartRefresh();
        }, getChartRefreshIntervalMs(tier));
      }

      async function updateChart() {
        try {
          const rangeSelectorEl = document.getElementById('rangeSelector');
          const meineAuswahl = rangeSelectorEl.value;
          const [rangeStr, tier] = meineAuswahl.split('|');
          const range = parseFloat(rangeStr);

          // Vor dem Fetch berechnen, damit der Server von vornherein nur die
          // tatsächlich benötigten Punkte erzeugt und überträgt, statt immer
          // den kompletten Tier-Puffer zu schicken (der Client hat den Rest
          // bisher ohnehin sofort wieder verworfen - reine Verschwendung an
          // Erzeugungs- und Übertragungszeit, besonders bei kurzen Zeiträumen
          // wie "10 Minuten" innerhalb des 1h-Tier1-Puffers).
          const pointsPerHour = 3600 / getIntervalInSeconds(tier);
          const totalPoints = Math.floor(range * pointsPerHour);

          const r = await fetch('/chartdata?tier=' + tier + '&count=' + totalPoints);
          const d = await r.json();

          // Läuft parallel zum manuellen Umschalten auch alle 5 Sekunden ein
          // automatischer Refresh - ohne diese Prüfung kann eine ältere, noch
          // nicht beantwortete Anfrage NACH einer neueren zurückkommen und das
          // Diagramm kurz auf einen veralteten Zeitraum zurückwerfen (sichtbar
          // als "hin- und herspringen" nach dem Umschalten). Hat sich die
          // Auswahl seit Anfragestart geändert, wird diese Antwort verworfen.
          if (rangeSelectorEl.value !== meineAuswahl) return;

          // Der Server liefert mit "count" bereits nur noch die benötigten
          // Punkte - das Slicing hier bleibt trotzdem als Absicherung stehen
          // (z.B. falls "count" mal ohne aktualisierte Firmware ignoriert wird).
          const recent = d.slice(-totalPoints);

          // Anzeige-Verdichtung: reduziert bei Bedarf die Punktzahl fürs
          // Zeichnen, ohne Extremwerte zu verlieren (siehe verdichteFuerAnzeige).
          const { data: plotData, intervallSek } = verdichteFuerAnzeige(recent, getIntervalInSeconds(tier));

          // Echte Zeitstempel für die X-Achse (Näherung anhand der lokalen
          // Uhrzeit: der letzte Punkt = "jetzt", die anderen entsprechend älter)
          const now = new Date();
          const l = plotData.map((_, i) => {
            const secondsAgo = (plotData.length - 1 - i) * intervallSek;
            const timestamp = new Date(now.getTime() - secondsAgo * 1000);
            return formatTime(timestamp, tier);
          });
          const tdIn = plotData.map(p => p.td_in);
          const tdOut = plotData.map(p => p.td_out);
          const diff = plotData.map(p => p.diff);
          const diffMin = plotData.map(p => p.diff_min);
          const diffMax = plotData.map(p => p.diff_max);
          const rhIn = plotData.map(p => p.rh_in);
          const rhInMin = plotData.map(p => p.rh_in_min);
          const rhInMax = plotData.map(p => p.rh_in_max);
          const rhOut = plotData.map(p => p.rh_out);
          const rhOutMin = plotData.map(p => p.rh_out_min);
          const rhOutMax = plotData.map(p => p.rh_out_max);
          const status = plotData.map(p => p.status);

          const rhSollMin = ZIEL_RH - HYSTERESE;
          const rhSollMax = ZIEL_RH + HYSTERESE;

          if (!chartInitialized) {
            const cc = chartColors();
            // Min-Max-Spannweite als schattierter Bereich zwischen zwei
            // unsichtbaren Linien (Chart.js "fill" zwischen zwei Datasets).
            // Bewusst UNABHÄNGIG vom aktiven Regelmodus: sowohl der
            // Austrocknungsschutz (rh_in-Tiefpunkt, wirkt in jedem Modus) als
            // auch die klassische Taupunktdifferenz-Schwelle interessieren sich
            // für die tatsächlich aufgetretenen Extremwerte, nicht nur für den
            // Durchschnitt - deshalb kein Umschalten je nach Modus, sondern
            // immer beide Extreme als durchgehende Spannweite sichtbar.
            chart = new Chart(document.getElementById('chart'), {
              type: 'line',
              data: {
                labels: l,
                datasets: [
                  { label: '', data: diffMin, borderColor: 'rgba(0,0,0,0)', backgroundColor: 'rgba(0,0,0,0)', fill: false, pointRadius: 0, order: 3 },
                  { label: 'Differenz-Spannweite (Min-Max)', data: diffMax, borderColor: 'rgba(0,0,0,0)', backgroundColor: 'rgba(255,140,0,0.3)', fill: '-1', pointRadius: 0, order: 3 },
                  { label: 'Taupunkt Innen', data: tdIn, borderColor: COLOR_TD_IN, borderWidth: 2, fill: false, pointStyle: 'circle', pointRadius: 0, order: 1},
                  { label: 'Taupunkt Außen', data: tdOut, borderColor: COLOR_TD_OUT, borderWidth: 2, fill: false, pointStyle: 'circle', pointRadius: 0, order: 1},
                  { label: 'Differenz', data: diff, borderColor: COLOR_DIFF, borderWidth: 2, fill: false, pointStyle: 'circle', pointRadius: 0, order: 1},
                  { label: 'Schwellwert +', data: Array(l.length).fill(SCHWELLWERT), borderDash: [5, 5], borderColor: COLOR_SCHWELL, borderWidth: 1, fill: false, pointStyle: 'circle', pointRadius: 0, order: 2},
                  { label: 'Schwellwert -', data: Array(l.length).fill(-SCHWELLWERT), borderDash: [5, 5], borderColor: COLOR_SCHWELL, borderWidth: 1, fill: false, pointStyle: 'circle', pointRadius: 0, order: 2}
                ]
              },
              options: {
                responsive: true,
                maintainAspectRatio: false, // Höhe kommt jetzt vom .chart-wrap-div, nicht mehr vom canvas-Seitenverhältnis
                plugins: { legend: { labels: { usePointStyle: true, pointStyle: 'line', color: cc.text, filter: item => item.text !== '' } } },
                scales: {
                  x: { ticks: { color: cc.text, maxRotation: 45, minRotation: 30, autoSkip: true, maxTicksLimit: 10 }, grid: { color: cc.grid } },
                  y: { ticks: { color: cc.text }, grid: { color: cc.grid } }
                }
              }
            });

            chart_humidity = new Chart(document.getElementById('chart_humidity'), {
              type: 'line',
              data: {
                labels: l,
                datasets: [
                  { label: '', data: rhInMin, borderColor: 'rgba(0,0,0,0)', backgroundColor: 'rgba(0,0,0,0)', fill: false, pointRadius: 0, order: 3 },
                  { label: 'RH Innen-Spannweite (Min-Max)', data: rhInMax, borderColor: 'rgba(0,0,0,0)', backgroundColor: 'rgba(0,128,128,0.3)', fill: '-1', pointRadius: 0, order: 3 },
                  { label: '', data: rhOutMin, borderColor: 'rgba(0,0,0,0)', backgroundColor: 'rgba(0,0,0,0)', fill: false, pointRadius: 0, order: 3 },
                  { label: 'RH Außen-Spannweite (Min-Max)', data: rhOutMax, borderColor: 'rgba(0,0,0,0)', backgroundColor: 'rgba(128,0,128,0.3)', fill: '-1', pointRadius: 0, order: 3 },
                  { label: 'RH Innen', data: rhIn, borderColor: 'teal', borderWidth: 2, fill: false, pointStyle: 'circle', pointRadius: 0, order: 1},
                  { label: 'RH Außen', data: rhOut, borderColor: 'purple', borderWidth: 2, fill: false, pointStyle: 'circle', pointRadius: 0, order: 1},
                  { label: 'Zielband +', data: Array(l.length).fill(FEUCHTEREGELUNG_AKTIV ? rhSollMax : null), borderDash: [5, 5], borderColor: COLOR_SCHWELL, borderWidth: 1, fill: false, pointStyle: 'circle', pointRadius: 0, order: 2},
                  { label: 'Zielband -', data: Array(l.length).fill(FEUCHTEREGELUNG_AKTIV ? rhSollMin : null), borderDash: [5, 5], borderColor: COLOR_SCHWELL, borderWidth: 1, fill: false, pointStyle: 'circle', pointRadius: 0, order: 2}
                ]
              },
              options: {
                responsive: true,
                maintainAspectRatio: false, // Höhe kommt jetzt vom .chart-wrap-div, nicht mehr vom canvas-Seitenverhältnis
                plugins: { legend: { labels: { usePointStyle: true, pointStyle: 'line', color: cc.text, filter: item => item.text !== '' } } },
                scales: {
                  x: { ticks: { color: cc.text, maxRotation: 45, minRotation: 30, autoSkip: true, maxTicksLimit: 10 }, grid: { color: cc.grid } },
                  y: { ticks: { color: cc.text }, grid: { color: cc.grid } }
                }
              }
            });

            chart_status = new Chart(document.getElementById('chart_status'), {
              type: 'bar',
              data: {
                labels: l,
                datasets: [{ label: 'Lüftung', data: status, backgroundColor: status.map(s => s === 1 ? COLOR_STATUS_ON : COLOR_STATUS_OFF) }]
              },
              options: {
                responsive: true,
                maintainAspectRatio: false, // Höhe kommt jetzt vom .chart-wrap-div, nicht mehr vom canvas-Seitenverhältnis
                plugins: { legend: { labels: { color: cc.text } } },
                scales: {
                  x: { ticks: { color: cc.text, maxRotation: 45, minRotation: 30, autoSkip: true, maxTicksLimit: 10 }, grid: { color: cc.grid } },
                  y: {
                    beginAtZero: true, max: 1,
                    ticks: {
                      color: cc.text, stepSize: 1,
                      autoSkip: false,
                      callback: function(value) { return value === 1 ? 'AN' : 'AUS'; }
                    },
                    grid: { color: cc.grid }
                  }
                }
              }
            });

            chartInitialized = true;
          } else {
            chart.data.labels = l;
            chart.data.datasets[0].data = diffMin;
            chart.data.datasets[1].data = diffMax;
            chart.data.datasets[2].data = tdIn;
            chart.data.datasets[3].data = tdOut;
            chart.data.datasets[4].data = diff;
            chart.data.datasets[5].data = Array(l.length).fill(SCHWELLWERT);
            chart.data.datasets[6].data = Array(l.length).fill(-SCHWELLWERT);
            chart.update('none');

            chart_humidity.data.labels = l;
            chart_humidity.data.datasets[0].data = rhInMin;
            chart_humidity.data.datasets[1].data = rhInMax;
            chart_humidity.data.datasets[2].data = rhOutMin;
            chart_humidity.data.datasets[3].data = rhOutMax;
            chart_humidity.data.datasets[4].data = rhIn;
            chart_humidity.data.datasets[5].data = rhOut;
            chart_humidity.data.datasets[6].data = Array(l.length).fill(FEUCHTEREGELUNG_AKTIV ? rhSollMax : null);
            chart_humidity.data.datasets[7].data = Array(l.length).fill(FEUCHTEREGELUNG_AKTIV ? rhSollMin : null);
            chart_humidity.update('none');

            chart_status.data.labels = l;
            chart_status.data.datasets[0].data = status;
            chart_status.data.datasets[0].backgroundColor = status.map(s => s === 1 ? COLOR_STATUS_ON : COLOR_STATUS_OFF);
            chart_status.update('none');
          }
        } catch (e) {
          console.error("Chart-Update-Fehler:", e);
        }
      }

      function updateElementValue(id, value, unit = "") {
        const el = document.getElementById(id);
        if (!el) return;
        const isValid = typeof value === "number" && !isNaN(value);
        if (isValid) {
          el.textContent = value.toFixed(1) + unit;
          el.style.color = "";
          el.title = "";
        } else {
          el.textContent = "NaN";
          el.style.color = "red";
          el.title = "Sensorwert ungültig oder nicht verfügbar";
        }
      }

      async function updateLiveData() {
        try {
          const res = await fetch('/livedata');
          const data = await res.json();
          if (typeof data.schwelle === 'number' && !isNaN(data.schwelle)) SCHWELLWERT = data.schwelle;
          if (typeof data.feuchteregelungAktiv === 'boolean') FEUCHTEREGELUNG_AKTIV = data.feuchteregelungAktiv;
          if (typeof data.zielRh === 'number' && !isNaN(data.zielRh)) ZIEL_RH = data.zielRh;
          if (typeof data.hysterese === 'number' && !isNaN(data.hysterese)) HYSTERESE = data.hysterese;
          document.getElementById('zeit').textContent = data.zeit;
          document.getElementById('status_text').textContent = data.status;
          document.getElementById('timer_info').textContent = data.timer || "–";
          updateElementValue('t_in', data.t_in, '°C');
          updateElementValue('rh_in', data.rh_in, '%');
          updateElementValue('t_out', data.t_out, '°C');
          updateElementValue('rh_out', data.rh_out, '%');
          updateElementValue('td_in', data.td_in, '°C');
          updateElementValue('td_out', data.td_out, '°C');
        } catch (e) {
          console.error("Live-Daten-Fehler:", e);
        }
      }

      // Intervall-ID an der Funktion selbst gespeichert (gleiches Muster wie
      // scheduleChartRefresh/openFirmwareModalUI) statt in einer neuen
      // globalen Variable.
      function startLiveDataPolling() {
        if (startLiveDataPolling.intervalId) return;
        updateLiveData();
        startLiveDataPolling.intervalId = setInterval(updateLiveData, 5000);
      }

      function stopLiveDataPolling() {
        if (startLiveDataPolling.intervalId) {
          clearInterval(startLiveDataPolling.intervalId);
          startLiveDataPolling.intervalId = null;
        }
      }

      function resolveTheme(t) {
        if (t === 'system') {
          return window.matchMedia('(prefers-color-scheme: dark)').matches ? 'dark' : 'light';
        }
        return t;
      }

      function chartColors() {
        const dark = document.documentElement.getAttribute('data-theme') === 'dark';
        return {
          text: dark ? '#c9d1d9' : '#333333',
          grid: dark ? 'rgba(255,255,255,0.10)' : 'rgba(0,0,0,0.08)'
        };
      }

      function applyChartTheme() {
        const c = chartColors();
        [chart, chart_humidity, chart_status].forEach(ch => {
          if (!ch) return;
          if (ch.options.plugins && ch.options.plugins.legend && ch.options.plugins.legend.labels) {
            ch.options.plugins.legend.labels.color = c.text;
          }
          if (ch.options.scales) {
            ['x', 'y'].forEach(axis => {
              if (ch.options.scales[axis]) {
                ch.options.scales[axis].ticks = Object.assign({}, ch.options.scales[axis].ticks, { color: c.text });
                ch.options.scales[axis].grid = Object.assign({}, ch.options.scales[axis].grid, { color: c.grid });
              }
            });
          }
          ch.update('none');
        });
      }

      function setTheme(t) {
        localStorage.setItem('theme', t);
        document.documentElement.setAttribute('data-theme', resolveTheme(t));
        applyChartTheme();
      }

      // Wenn "System" gewählt ist und sich die Betriebssystem-Einstellung
      // während der offenen Seite ändert, live nachziehen statt erst beim
      // nächsten Laden.
      window.matchMedia('(prefers-color-scheme: dark)').addEventListener('change', () => {
        if ((localStorage.getItem('theme') || 'system') === 'system') {
          document.documentElement.setAttribute('data-theme', resolveTheme('system'));
          applyChartTheme();
        }
      });

      function showTab(tab) {
        document.getElementById('dashboardTab').classList.add('hidden');
        document.getElementById('settingsTab').classList.add('hidden');
        document.getElementById(tab + 'Tab').classList.remove('hidden');
        localStorage.setItem("activeTab", tab);
        if (tab === 'dashboard') {
          updateLiveData();
          updateChart();
        }
        if (tab === 'settings' && localStorage.getItem('manualSettingsClick') === 'true') {
          openFirmwareModalUI();
          localStorage.removeItem('manualSettingsClick');
        }
      }

      function toggleMQTT(el) {
        const form = el.closest("form");
        const hidden = form.querySelector("input[name='mqtt']");
        const aktivieren = el.checked;
        hidden.value = aktivieren ? "MQTT aktivieren" : "MQTT deaktivieren";

        fetch('/setMQTT', {
          method: "POST",
          body: new URLSearchParams(new FormData(form))
        }).then(() => {
          document.getElementById('mqttModusFelder').classList.toggle('hidden', !aktivieren);
          document.getElementById('mqttFieldset').classList.toggle('hidden', !aktivieren);
        });
      }

      function openFirmwareModalUI() {
        const modal = document.getElementById("firmwareModal");
        modal.classList.remove("hidden");
        if (!openFirmwareModalUI.listenerAdded) {
          document.addEventListener("keydown", escCloseModal);
          document.addEventListener("click", outsideClickModal);
          openFirmwareModalUI.listenerAdded = true;
        }
      }

      function closeFirmwareModal() {
        const modal = document.getElementById("firmwareModal");
        modal.classList.add("hidden");
        if (openFirmwareModalUI.listenerAdded) {
          document.removeEventListener("keydown", escCloseModal);
          document.removeEventListener("click", outsideClickModal);
          openFirmwareModalUI.listenerAdded = false;
        }
      }

      function escCloseModal(e) {
        if (e.key === "Escape") closeFirmwareModal();
      }

      function rebootDevice() {
        if (!confirm("Gerät wirklich neu starten? Die Verbindung geht kurz verloren.")) return;
        fetch("/reboot", { method: "POST" }).catch(() => {});
        document.body.innerHTML = "<div style='text-align:center;margin-top:50px;font-family:sans-serif;'>" +
          "<h3>Neustart läuft…</h3><p>Seite lädt automatisch neu, sobald das Gerät wieder erreichbar ist.</p></div>";
        waitForReboot();
      }

      function waitForReboot() {
        setTimeout(() => {
          fetch("/livedata")
            .then(() => location.reload())
            .catch(() => waitForReboot());
        }, 2000);
      }

      function wifiResetDevice() {
        if (!confirm("WLAN-Zugangsdaten wirklich löschen?\n\nDas Gerät startet neu und öffnet danach den Setup-Access-Point „TaupunktLueftung-Setup“. Alle anderen Einstellungen bleiben erhalten.")) return;
        fetch("/wifireset", { method: "POST" }).catch(() => {});
        document.body.innerHTML = "<div style='text-align:center;margin-top:50px;font-family:sans-serif;'>" +
          "<h3>WLAN-Reset läuft…</h3><p>Verbinde dich anschließend mit dem WLAN „TaupunktLueftung-Setup“, um ein neues Netz einzurichten.</p></div>";
      }

      function submitBenutzernameForm(e) {
        e.preventDefault();
        const neu = document.getElementById('user_neu').value.trim();
        if (!neu) { alert("Bitte einen Benutzernamen eingeben."); return false; }

        fetch('/setUsername', {
          method: "POST",
          body: new URLSearchParams({ neuer_benutzername: neu })
        }).then(res => {
          if (res.ok) {
            alert("Benutzername geändert. Der Browser fragt jetzt neu nach den Zugangsdaten - dort den neuen Benutzernamen eingeben.");
            location.reload();
          } else {
            res.text().then(msg => alert("Fehler: " + msg));
          }
        }).catch(err => {
          console.error("Benutzername-Änderung fehlgeschlagen:", err);
          alert("Fehler beim Speichern des Benutzernamens (Verbindung geprüft?).");
        });
        return false;
      }

      function submitPasswortForm(e) {
        e.preventDefault();
        const neu = document.getElementById('pw_neu').value;
        const bestaetigung = document.getElementById('pw_bestaetigen').value;
        if (!neu) { alert("Bitte ein neues Passwort eingeben."); return false; }
        if (neu !== bestaetigung) { alert("Die Passwörter stimmen nicht überein."); return false; }

        fetch('/setPassword', {
          method: "POST",
          body: new URLSearchParams({ neues_passwort: neu, passwort_bestaetigen: bestaetigung })
        }).then(res => {
          if (res.ok) {
            alert("Passwort geändert. Der Browser fragt jetzt neu nach den Zugangsdaten - dort das neue Passwort eingeben.");
            location.reload();
          } else {
            res.text().then(msg => alert("Fehler: " + msg));
          }
        }).catch(err => {
          console.error("Passwort-Änderung fehlgeschlagen:", err);
          alert("Fehler beim Speichern des Passworts (Verbindung geprüft?).");
        });
        return false;
      }

      function outsideClickModal(e) {
        const modal = document.getElementById("firmwareModal");
        const modalContent = document.querySelector(".modal-content");
        if (!modal.classList.contains("hidden") && !modalContent.contains(e.target)) {
          closeFirmwareModal();
        }
      }

      function confirmFirmwareUpdate() {
        return confirm("Firmware-Update vorbereiten?\n\n- MQTT wird getrennt\n- Sensorlogik pausiert\n\nJetzt fortfahren?");
      }

      // ===== Firmware-Upload mit Wartesseite =====
      // Vorher: normales <form>-POST - der Browser navigiert weg und zeigt bis
      // zur Antwort nur seinen eigenen (nichtssagenden) Lade-Indikator. Jetzt
      // übernimmt fetch() den Upload, damit wir zwischen Klick und Ergebnis
      // eine eigene "Wird verifiziert..."-Seite zeigen können, und damit das
      // JS anhand von res.ok (200 vs. 500) zuverlässig zwischen Erfolg und
      // Fehlschlag unterscheiden kann.
      function submitFirmwareUpdate(e) {
        e.preventDefault();
        if (!confirmFirmwareUpdate()) return false;

        const formData = new FormData(document.getElementById('firmwareUploadForm'));

        document.body.innerHTML = "<div style='text-align:center;margin-top:50px;font-family:sans-serif;'>" +
          "<h3>Firmware wird hochgeladen und verifiziert…</h3>" +
          "<p>Bitte warten - je nach Dateigröße und WLAN-Geschwindigkeit kann das einen Moment dauern.<br>" +
          "Bei Erfolg startet das Gerät automatisch neu.</p></div>";

        fetch('/update', { method: "POST", body: formData })
          .then(res => res.text().then(html => ({ ok: res.ok, html })))
          .then(({ ok, html }) => {
            if (ok) {
              document.body.innerHTML = "<div style='text-align:center;margin-top:50px;font-family:sans-serif;'>" +
                "<h3>Firmware verifiziert, Update erfolgreich.</h3>" +
                "<p>Neustart läuft… Seite lädt automatisch neu, sobald das Gerät wieder erreichbar ist.</p></div>";
              waitForReboot();
            } else {
              // Fehlerseite vom Gerät 1:1 übernehmen (enthält Details + Link zurück)
              document.open();
              document.write(html);
              document.close();
            }
          })
          .catch(err => {
            console.error("Firmware-Upload fehlgeschlagen:", err);
            document.body.innerHTML = "<div style='text-align:center;margin-top:50px;font-family:sans-serif;'>" +
              "<h3>Firmware-Upload fehlgeschlagen.</h3>" +
              "<p>Verbindung zum Gerät unterbrochen? Bitte Seite neu laden und erneut versuchen.</p></div>";
          });

        return false;
      }

      window.onload = () => {
        openFirmwareModalUI.listenerAdded = false;

        // Gespeicherten Zeitraum VOR dem ersten showTab()/updateChart()-Aufruf
        // wiederherstellen, damit gleich beim Laden der richtige Zeitraum
        // gezeichnet wird, statt kurz auf "10 Minuten" zu springen.
        const rangeSel = document.getElementById('rangeSelector');
        const savedRange = localStorage.getItem('chartRange');
        if (rangeSel && savedRange && [...rangeSel.options].some(o => o.value === savedRange)) {
          rangeSel.value = savedRange;
        }

        const savedTab = localStorage.getItem("stayOnSettings") === "true" ? "settings" : "dashboard";
        localStorage.removeItem("stayOnSettings");
        showTab(savedTab);

        const themeSel = document.getElementById('themeSelect');
        if (themeSel) themeSel.value = localStorage.getItem('theme') || 'system';

        startLiveDataPolling();
        scheduleChartRefresh();

        // Page Visibility API: pausiert das Polling komplett, sobald der Tab
        // in den Hintergrund geht (z.B. Handy gesperrt, anderer Tab aktiv,
        // Browser minimiert) - viele mobile Browser drosseln Hintergrund-Tabs
        // nicht zuverlässig selbst, wodurch offene Tabs sonst dauerhaft weiter
        // pollen, auch wenn niemand hinschaut. Bei mehreren offen gelassenen
        // Geräten kann sich das gegenseitig verstärken und den (einsträngigen)
        // Server durchgehend beschäftigt halten, ohne dass jemand aktiv
        // das Interface nutzt.
        document.addEventListener('visibilitychange', () => {
          if (document.hidden) {
            stopLiveDataPolling();
            if (scheduleChartRefresh.timeoutId) {
              clearTimeout(scheduleChartRefresh.timeoutId);
              scheduleChartRefresh.timeoutId = null;
            }
          } else {
            startLiveDataPolling();
            scheduleChartRefresh();
          }
        });

        ajaxFormHandler("tempschutzForm", "Temperaturschutz gespeichert.");
        ajaxFormHandler("austrocknungsschutzForm", "Austrocknungsschutz gespeichert.");
        ajaxFormHandler("feuchteregelungForm", "Feuchteregelung gespeichert.");
        ajaxFormHandler("schwelleForm", "Schwellenwert gespeichert.");
        ajaxFormHandler("timerForm", "Timer gespeichert.");
        ajaxFormHandler("modusForm", "Sensor-Modus gespeichert.");
        ajaxFormHandler("mqttConfigForm", "MQTT-Verbindung gespeichert.");
        ajaxFormHandler("mqttTopicsForm", "MQTT Topics gespeichert.");
        ajaxFormHandler("discoveryForm", "MQTT Discovery gesendet.");
        ajaxFormHandler("discoveryPrefixForm", "Discovery Prefix gespeichert.");

        const debugAktivEl = document.getElementById('debug_aktiv');
        if (debugAktivEl && debugAktivEl.checked) startDebugPolling();
      };

      function ajaxFormHandler(formId, successMessage = "Gespeichert!") {
        const form = document.getElementById(formId);
        if (!form) return;
        form.addEventListener("submit", function (e) {
          e.preventDefault();
          const data = new FormData(form);
          fetch(form.action, { method: "POST", body: new URLSearchParams(data) })
            .then(res => {
              if (res.ok) {
                alert(successMessage);
              } else {
                res.text().then(msg => alert("Fehler: " + msg));
              }
            })
            .catch(err => { console.error("AJAX-Fehler:", err); });
        });
      }

      // ===== Debug-Ausgabe =====
      function submitDebugSettings() {
        const form = document.getElementById('debugForm');
        fetch('/debugsettings', { method: 'POST', body: new URLSearchParams(new FormData(form)) }).then(() => {
          const aktiv = document.getElementById('debug_aktiv').checked;
          document.getElementById('debugKategorien').classList.toggle('hidden', !aktiv);
          document.getElementById('debugLeerenWrap').classList.toggle('hidden', !aktiv);
          document.getElementById('debugAusgabe').classList.toggle('hidden', !aktiv);
          if (aktiv) startDebugPolling(); else stopDebugPolling();
        });
      }

      async function leereDebugAusgabe() {
        try {
          await fetch('/debugclear', { method: 'POST' });
          const el = document.getElementById('debugAusgabe');
          if (el) el.textContent = ''; // sofortiges Feedback, statt auf den nächsten Poll zu warten
        } catch (e) {
          console.error("Debug-Log-Leeren-Fehler:", e);
        }
      }

      async function updateDebugLog() {
        // Nur abfragen, solange die Einstellungsseite tatsächlich sichtbar ist -
        // sonst würde unnötig weiter gepollt, während z.B. das Dashboard offen ist.
        const settingsTab = document.getElementById('settingsTab');
        if (!settingsTab || settingsTab.classList.contains('hidden')) return;
        try {
          const res = await fetch('/debuglog');
          const text = await res.text();
          const el = document.getElementById('debugAusgabe');
          if (el) el.textContent = text;
        } catch (e) {
          console.error("Debug-Log-Fehler:", e);
        }
      }

      // Intervall-ID an der Funktion selbst gespeichert (wie schon bei
      // scheduleChartRefresh/openFirmwareModalUI) statt in einer neuen
      // globalen Variable - vermeidet erneut Arduinos fragile Prototyp-Erkennung.
      function startDebugPolling() {
        if (startDebugPolling.intervalId) return;
        updateDebugLog();
        startDebugPolling.intervalId = setInterval(updateDebugLog, 3000);
      }

      function stopDebugPolling() {
        if (startDebugPolling.intervalId) {
          clearInterval(startDebugPolling.intervalId);
          startDebugPolling.intervalId = null;
        }
      }

  )rawliteral";

const char CSS_CONTENT[] PROGMEM = R"rawliteral(
    /* Nur zwei echte Theme-Definitionen: Hell (Default in :root) und Dunkel
       ([data-theme="dark"]). "System" ist keine eigene CSS-Definition, sondern
       wird per JS einmalig zur Ladezeit (und bei Änderung) in "light" oder
       "dark" aufgelöst - dadurch reicht diese eine Dunkel-Palette für beide
       Fälle, ohne sie ein zweites Mal für "System" zu duplizieren. */
    :root {
      color-scheme: light;
      --bg: #f8f9fa;
      --text: #2c5777;
      --fieldset-bg: #ffffffcc;
      --border: #ccc;
      --input-bg: white;
      --button-bg: #e1ecf4;
      --button-border: #7aa7c7;
      --button-text: #39739d;
      --button-hover-bg: #b3d3ea;
      --hint-color: gray;
      --chart-bg: white;
      --chart-border: #ccc;
      --chart-text: #333333;
      --chart-grid: rgba(0,0,0,0.08);
    }
    [data-theme="dark"] {
      /* color-scheme ist der eigentlich entscheidende Teil dieses Fixes:
         Ohne diese Zeile rendert der Browser native Bedienelemente
         (Checkbox, Zahlen-Spinner, z.T. auch Scrollbars) weiterhin in
         seiner hellen Standardoptik, unabhängig von unseren eigenen
         --bg/--text-Variablen - genau das sorgte für die grellen Felder. */
      color-scheme: dark;
      /* Bewusst kein reines Schwarz und kein reines Weiß - angenehmerer
         Kontrast für längeres Ablesen des Dashboards. */
      --bg: #22262b;
      --text: #c9d1d9;
      --fieldset-bg: #2b2f36cc;
      --border: #3a3f47;
      --input-bg: #2b2f36;
      --button-bg: #333a42;
      --button-border: #4d6a80;
      --button-text: #a8c5da;
      --button-hover-bg: #3f4750;
      --hint-color: #8b939b;
      --chart-bg: #2b2f36;
      --chart-border: #3a3f47;
      --chart-text: #c9d1d9;
      --chart-grid: rgba(255,255,255,0.10);
    }

    body {
      font-family: Arial, sans-serif;
      background: var(--bg);
      margin: 20px;
      color: var(--text);
    }
    h1 { color: var(--text); }
    form { margin: 20px 0; }
    /* Chart-Hintergrund folgt jetzt dem Theme; die Achsen-/Legendenfarben
       werden zusätzlich im JS gesetzt, da Chart.js diese nicht aus CSS liest. */
    canvas { background: var(--chart-bg); border: 1px solid var(--chart-border); }
.chart-wrap { position: relative; width: 100%; margin-bottom: 20px; }
.hidden { display: none !important; }

    button, input[type='submit'], input[type='button'], .button-link {
      background-color: var(--button-bg);
      border-radius: 3px;
      border: 1px solid var(--button-border);
      box-shadow: rgba(255, 255, 255, .7) 0 1px 0 0 inset;
      box-sizing: border-box;
      color: var(--button-text);
      cursor: pointer;
      display: inline-block;
      font-family: -apple-system,system-ui,"Segoe UI","Liberation Sans",sans-serif;
      font-size: 13px;
      font-weight: 400;
      line-height: 1.15385;
      margin: 5px 5px 5px 0;
      outline: none;
      padding: 8px .8em;
      position: relative;
      text-align: center;
      text-decoration: none;
      user-select: none;
      vertical-align: baseline;
      white-space: nowrap;
    }

    button:hover, input[type='submit']:hover, input[type='button']:hover, .button-link:hover {
      background-color: var(--button-hover-bg);
      color: var(--text);
    }

    button:focus, input[type='submit']:focus, input[type='button']:focus {
      box-shadow: 0 0 0 4px rgba(0, 149, 255, .15);
    }

    button:active, input[type='submit']:active, input[type='button']:active {
      background-color: var(--button-hover-bg);
      box-shadow: none;
      color: var(--text);
    }

    a.button-link { text-align: center; }

    select {
      padding: 5px 10px;
      font-size: 1em;
      border: 1px solid var(--border);
      border-radius: 5px;
      background-color: var(--input-bg);
      color: var(--text);
      margin: 5px 0;
      appearance: none;
      -webkit-appearance: none;
      -moz-appearance: none;
    }
    select:focus {
      outline: none;
      border-color: #007bff;
      box-shadow: 0 0 3px #007bff55;
    }

    .switch { position: relative; display: inline-block; width: 50px; height: 24px; margin-left: 10px; }
    .switch input { display: none; }
    .slider {
      position: absolute; cursor: pointer; background-color: #ccc; border-radius: 24px;
      top: 0; left: 0; right: 0; bottom: 0; transition: 0.4s;
    }
    .slider:before {
      content: ""; position: absolute; height: 18px; width: 18px; left: 3px; bottom: 3px;
      background-color: white; border-radius: 50%; transition: 0.4s;
    }
    input:checked + .slider { background-color: #007bff; }
    input:checked + .slider:before { transform: translateX(26px); }

    .modal {
      position: fixed; top: 0; left: 0; width: 100%; height: 100%; z-index: 1000;
      background: rgba(0,0,0,0.5); display: flex; align-items: center; justify-content: center;
    }
    .modal.hidden { display: none !important; }
    .modal-content {
      background: var(--fieldset-bg); padding: 20px; border-radius: 10px; max-width: 400px; width: 90%;
      box-shadow: 0 0 10px #000; position: relative; color: var(--text);
    }
    .close { position: absolute; top: 10px; right: 15px; font-size: 1.5em; cursor: pointer; }

    fieldset {
      border: 1px solid var(--border); border-radius: 8px; padding: 10px 15px;
      margin-bottom: 20px; background-color: var(--fieldset-bg);
    }
    legend { font-weight: bold; padding: 0 5px; color: var(--text); }
    input[type='text'], input[type='number'], input[type='password'], select, textarea {
      color: var(--text);
      background-color: var(--input-bg);
      border: 1px solid var(--border);
    }
    input[type='checkbox'] {
      /* Ergänzt color-scheme (siehe :root/[data-theme="dark"] oben): passt
         zusätzlich die Häkchen-/Rahmenfarbe der Checkbox ans Theme an. */
      accent-color: var(--button-border);
    }
  )rawliteral";

void handleCSS() {
  // Cache-Control: der Browser fragt /style.css dann nicht mehr bei jedem
  // Seitenaufruf komplett neu beim ESP32 an, sondern nur einmal pro Stunde
  // (bzw. bis der Browser-Cache geleert wird). Ändert sich das CSS durch ein
  // Firmware-Update, bekommt der Browser es spätestens nach Ablauf der
  // max-age automatisch wieder frisch.
  server.sendHeader("Cache-Control", "public, max-age=3600");
  server.send_P(200, "text/css", CSS_CONTENT);
}

void handleScriptJS() {
  // Siehe Kommentar bei handleCSS() - gleiches Prinzip fürs JavaScript, das
  // vorher bei jedem Seitenaufruf komplett inline mitgeschickt wurde.
  server.sendHeader("Cache-Control", "public, max-age=3600");
  server.send_P(200, "application/javascript", MAIN_SCRIPT_JS);
}

void handleRoot() {
  server.setContentLength(CONTENT_LENGTH_UNKNOWN);
  server.send(200, "text/html", "");

  // Das <html>-Tag bekommt sofort per winzigem Inline-Script data-theme gesetzt,
  // noch bevor das eigentliche CSS/JS (aus /style.css bzw. PROGMEM) geladen ist.
  // So gibt es keinen kurzen "hellen Blitz" beim Laden im Dark-Mode. Die
  // eigentliche Logik (CSS-Variablen je nach data-theme) steckt komplett im
  // ohnehin vorhandenen CSS - hier kommt nur die Zuweisung dazu, kein neuer
  // Speicherbedarf auf dem ESP32 (Theme-Wahl lebt rein im Browser/localStorage).
  // "System" wird hier einmalig in "light" oder "dark" aufgelöst und als
  // data-theme gesetzt - das CSS kennt dadurch nur noch zwei echte
  // Definitionen (Default = hell, [data-theme="dark"]), keine dritte
  // Duplizierung für "System". localStorage speichert weiterhin die
  // ursprüngliche Wahl (inkl. "system"), damit das Dropdown korrekt anzeigt.
  server.sendContent("<!DOCTYPE html><html><head><meta charset='UTF-8'>"
                      "<script>(function(){"
                      "var t=localStorage.getItem('theme')||'system';"
                      "var r=(t==='system')?(window.matchMedia('(prefers-color-scheme: dark)').matches?'dark':'light'):t;"
                      "document.documentElement.setAttribute('data-theme', r);"
                      "})();</script>"
                      "<title>" + String(NAME) + "</title>"
                      // ?v=FIRMWARE_VERSION als Cache-Buster: /style.css hat unten einen
                      // Cache-Control: max-age=3600-Header. Ohne diesen Query-Parameter
                      // würde ein Browser nach einem Firmware-Update bis zu eine Stunde
                      // lang noch das alte, zwischengespeicherte CSS verwenden - genau das
                      // Verhalten, das gerade auf dem Handy beobachtet wurde (nur nach
                      // manuellem Cache-Leeren kam die aktuelle Seite). Ändert sich die
                      // Firmware-Version, ist die URL für den Browser "neu" und wird frisch
                      // geladen; bleibt die Version gleich, greift der Cache weiter normal.
                      "<link rel='stylesheet' href='/style.css?v=" + String(BUILD_STAMP) + "'></head><body>");
  server.sendContent("<h1 style='display:inline-block;'>" + String(NAME) + " " + String(FIRMWARE_VERSION) + " Interface</h1>");
  server.sendContent("<span style='float:right;'>"
                      "<label for='themeSelect'>Design:</label> "
                      "<select id='themeSelect' onchange='setTheme(this.value)'>"
                      "<option value='light'>Hell</option>"
                      "<option value='dark'>Dunkel</option>"
                      "<option value='system'>System</option>"
                      "</select></span>");

  server.sendContent("<p><button onclick=\"showTab('dashboard')\">Dashboard</button>"
                      "<button onclick=\"localStorage.setItem('manualSettingsClick','true'); showTab('settings')\">Einstellungen</button>");

  server.sendContent(getDashboardHtml());
  server.sendContent(getSettingsHtml());
  server.sendContent(getFirmwareModalHtml());

  // Chart.js bleibt eine externe CDN-Referenz (vom Browser ohnehin über
  // dessen eigenen HTTP-Cache verwaltet); das eigene JavaScript kommt jetzt
  // über die eigene, cachebare Route /script.js statt inline - siehe
  // Kommentar bei MAIN_SCRIPT_JS und handleScriptJS(). ?v=FIRMWARE_VERSION
  // als Cache-Buster, siehe Kommentar bei /style.css oben.
  server.sendContent("<script src='https://cdn.jsdelivr.net/npm/chart.js'></script>");
  server.sendContent("<script src='/script.js?v=" + String(BUILD_STAMP) + "'></script>");

  server.sendContent("</body></html>");
  server.sendContent("");
}

// Erkennt, ob noch die Auslieferungs-Zugangsdaten aktiv sind (admin/admin123).
// Dient nur als Erinnerung im Dashboard, ist kein Sicherheitsmechanismus.
bool verwendetStandardZugangsdaten() {
  return strcmp(configUsername, "admin") == 0 && strcmp(configPassword, "admin123") == 0;
}

String getDashboardHtml() {
  String html;
  html += "<div id='dashboardTab'>";
  if (verwendetStandardZugangsdaten()) {
    html += "<p style='background:#f8d7da; color:#721c24; border:1px solid #f5c6cb; border-radius:6px; padding:10px 14px; margin-bottom:16px;'>"
            "&#9888; Es werden noch die Standard-Zugangsdaten (admin / admin123) verwendet. "
            "Bitte unter Einstellungen &rarr; Zugang (Login) ein eigenes Passwort vergeben.</p>";
  }
  html += "<div id='live'><p><strong>Zeit:</strong> <span id='zeit'></span><br>";
  html += "<strong>Innen:</strong> <span id='t_in'></span>, <span id='rh_in'></span><br>";
  html += "<strong>Außen:</strong> <span id='t_out'></span>, <span id='rh_out'></span><br>";
  html += "<strong>Taupunkt innen:</strong> <span id='td_in'></span><br>";
  html += "<strong>Taupunkt außen:</strong> <span id='td_out'></span></p></div>";
  html += "<p><strong>Status:</strong> <span id='status_text'></span></p>";
  html += "<p><strong>Timer:</strong> <span id='timer_info'></span></p>";
  html += "<p><strong>Letztes Ereignis:</strong> " + logEintrag + "</p>";
  html += "<form id='rangeForm' onsubmit='return false;'>"
          "<label><strong>Zeitraum:</strong></label> "
          "<select id='rangeSelector' onchange=\"localStorage.setItem('chartRange', this.value); updateChart(); scheduleChartRefresh();\">"
          "<option value='0.1|1'>10 Minuten</option>"
          "<option value='0.5|1'>30 Minuten</option>"
          "<option value='1|1'>1 Stunde</option>"
          "<option value='24|2'>24 Stunden</option>"
          "<option value='168|3'>7 Tage</option>"
          "<option value='720|3'>30 Tage</option>"
          "</select>"
          "</form>";
  html += "<div class='chart-wrap' style='height:280px;'><canvas id='chart'></canvas></div>";
  html += "<div class='chart-wrap' style='height:200px;'><canvas id='chart_humidity'></canvas></div>";
  html += "<div class='chart-wrap' style='height:100px;'><canvas id='chart_status'></canvas></div>";
  html += "</div>";
  return html;
}

String getSettingsHtml() {
  String html;
  html += "<div id='settingsTab' class='hidden'>";
  html += "<h2>Einstellungen</h2>";

  html += "<fieldset><legend>Temperaturschutz</legend>";
  html += "<form id='tempschutzForm' method='POST' action='/tempschutz'>";
  html += "<label title='Schützt die Innenraumluft vor zu starker Auskühlung durch Lüften. Hat Vorrang vor allen anderen Regeln, auch vor der Feuchteregelung.'>"
          "<input type='checkbox' name='aktiv'";
  if (schutzVorAuskuehlungAktiv) html += " checked";
  html += "> Aktivieren</label><br>";
  html += "Mindest-Innentemperatur (°C): <input type='number' step='0.1' name='min_temp' value='" + String(minTempInnen, 1) + "' "
          "title='Sinkt die Innentemperatur unter diesen Wert, wird die Lüftung sofort abgeschaltet und bleibt gesperrt, bis die Temperatur wieder darüber liegt.\nTipp: 12,0 °C ist ein guter Standardwert für die meisten Keller-/Wohnräume.'><br>";
  html += "<input type='submit' value='Speichern'></form></fieldset>";

  html += "<fieldset><legend>Austrocknungsschutz</legend>";
  html += "<form id='austrocknungsschutzForm' method='POST' action='/austrocknungsschutz'>";
  html += "<label title='Verhindert, dass die Innenluft durch fortgesetztes Lüften zu trocken wird. Wird als Erstes geprüft und hat Vorrang vor Temperaturschutz und Feuchteregelung.'>"
          "<input type='checkbox' name='aktiv'";
  if (schutzVorAustrocknungAktiv) html += " checked";
  html += "> Aktivieren</label><br>";
  html += "Mindest-RH innen (%): <input type='number' step='0.1' name='min_rh' value='" + String(minFeuchteInnen, 1) + "' "
          "title='Sinkt die relative Innenfeuchte unter diesen Wert, wird die Lüftung sofort abgeschaltet.\nTipp: 35,0 % ist ein guter Standardwert, um zu trockene Raumluft im Winter zu vermeiden.'><br>";
  html += "<input type='submit' value='Speichern'>";
  html += "</form></fieldset>";

  html += "<fieldset><legend>Feuchteregelung</legend>";
  html += "<form id='feuchteregelungForm' method='POST' action='/feuchteregelung'>";
  html += "<label title='Alternative Regelstrategie: Statt anhand der Taupunktdifferenz zu lüften, hält diese Funktion die Innenfeuchte aktiv in einem Zielband (siehe Ziel-RH und Hysterese). Ersetzt bei Aktivierung die klassische Taupunkt-Differenz-Logik samt Mindestlaufzeit/-pause.'>"
          "<input type='checkbox' name='aktiv'";
  if (konstanteFeuchteAktiv) html += " checked";
  html += "> Aktivieren</label><br>";
  html += "Ziel-RH innen (%): <input type='number' step='0.1' name='ziel_rh' value='" + String(zielFeuchteInnen, 1) + "' "
          "title='Gewünschte relative Innenfeuchte, die gehalten werden soll.\nTipp: 45,0 % ist für die meisten Wohnräume ein angenehmer Zielwert.'><br>";
  html += "Hysterese (%): <input type='number' step='0.1' name='hysterese' value='" + String(hysterese, 1) + "' "
          "title='Toleranzband um den Zielwert, innerhalb dessen nicht geregelt wird (Ziel-RH ± Hysterese).\nTipp: 2,0 % vermeidet zu häufiges Schalten um den Zielwert herum.'><br>";
  html += "<input type='submit' value='Speichern'>";
  html += "</form></fieldset>";

  html += "<fieldset><legend>Taupunkt-Differenz-Schwellenwert</legend>";
  html += "<form id='schwelleForm' method='POST' action='/setSchwelle'>";
  html += "Taupunkt-Differenz (°C), ab der gelüftet wird:<br>";
  html += "<input type='number' step='0.1' name='schwelle' value='" + String(taupunktDifferenzSchwellwert, 1) + "' "
          "title='Empfohlener Wert: 4,0 °C\n\nDie Außenluft muss mindestens so viel \"trockener\" sein (Taupunkt-Differenz), damit gelüftet wird.\n\nTipp: Höher = vorsichtiger, niedriger = aggressiver lüften.'><br>";
  html += "<input type='submit' value='Schwellenwert speichern'>";
  html += "</form></fieldset>";

  html += "<fieldset><legend>Lüfter/Relais-Schutzzeiten</legend>";
  html += "<form id='timerForm' method='POST' action='/timer'>";
  html += "Mindestlaufzeit (Minuten): <input type='number' name='laufzeit' value='" + String(mindestLaufzeit_ms / 60000) + "' "
          "title='Mindestzeit, die die Lüftung nach dem Einschalten aktiv bleiben muss.\n"
          "Verhindert zu schnelles Ausschalten und schützt das Relais vor häufigem Schalten.\n"
          "Tipp: 1–2 Minuten (0 Minuten = deaktiviert).'><br>";
  html += "Mindestpause (Minuten): <input type='number' name='pause' value='" + String(mindestPause_ms / 60000) + "' "
          "title='Mindestwartezeit nach dem Ausschalten, bevor die Lüftung erneut aktiviert werden darf.\n"
          "Dient dem Geräteschutz und reduziert unwirksames Lüften im Grenzbereich.\n"
          "Tipp: 5–10 Minuten als sanfte Sperre (0 Minuten = deaktiviert).'><br>";
  html += "<input type='submit' value='Timer speichern'>";
  html += "</form></fieldset>";

  // Sensorquelle: MQTT-Umschalter sitzt hier direkt, die Hardware/MQTT-Auswahl
  // für innen/außen wird nur eingeblendet, solange MQTT tatsächlich aktiv ist -
  // ohne aktives MQTT gibt es sonst nichts sinnvoll umzuschalten.
  html += "<fieldset><legend>Sensorquelle</legend>";
  html += "<form method='POST' action='/setMQTT'>";
  html += "<label for='mqtt_toggle' title='Aktiviert bzw. trennt die MQTT-Verbindung sofort. Nur bei aktivem MQTT lassen sich Sensorquellen auf \"MQTT\" stellen und erscheinen die MQTT-Einstellungen darunter.'>MQTT aktiv:</label>";
  html += "<input type='hidden' name='mqtt' value=''>";
  html += "<label class='switch'>";
  html += "<input type='checkbox' name='mqtt_toggle' id='mqtt_toggle' ";
  html += mqttAktiv ? "checked " : "";
  html += "onchange='toggleMQTT(this)'>";
  html += "<span class='slider round'></span>";
  html += "</label></form>";
  html += "<div id='mqttModusFelder' class='" + String(mqttAktiv ? "" : "hidden") + "'>";
  html += "<form id='modusForm' method='POST' action='/setModus'>";
  html += "Modus innen: <select name='modus_innen' title='Woher der Innensensor seine Werte bezieht: \"Hardware\" liest den lokal angeschlossenen Sensor, \"MQTT\" übernimmt Werte aus dem unten konfigurierten MQTT-Topic.'>";
  html += "<option value='hardware'" + String(modus_innen == "hardware" ? " selected" : "") + ">Hardware</option>";
  html += "<option value='mqtt'" + String(modus_innen == "mqtt" ? " selected" : "") + ">MQTT</option>";
  html += "</select><br>";
  html += "Modus außen: <select name='modus_aussen' title='Woher der Außensensor seine Werte bezieht: \"Hardware\" liest den lokal angeschlossenen Sensor, \"MQTT\" übernimmt Werte aus dem unten konfigurierten MQTT-Topic.'>";
  html += "<option value='hardware'" + String(modus_aussen == "hardware" ? " selected" : "") + ">Hardware</option>";
  html += "<option value='mqtt'" + String(modus_aussen == "mqtt" ? " selected" : "") + ">MQTT</option>";
  html += "</select><br>";
  html += "<input type='submit' value='Modus speichern'>";
  html += "</form>";
  html += "</div>";
  html += "</fieldset>";

  // MQTT-Fieldset (Verbindungsdaten, Topics, Discovery) - komplett ausgeblendet,
  // solange MQTT nicht aktiv ist. Der Toggle selbst sitzt jetzt oben bei Sensorquelle.
  html += "<fieldset id='mqttFieldset' class='" + String(mqttAktiv ? "" : "hidden") + "'><legend>MQTT</legend>";
  html += "<form id='mqttConfigForm' method='POST' action='/mqttconfig'>";
  html += "<p><strong>MQTT-Server</strong> Zugangsdaten:</p>";
  html += "Server: <input name='server' value='" + String(mqttServer) + "' "
          "title='Hostname oder IP-Adresse deines MQTT-Brokers, z. B. 192.168.1.10 oder mqtt.local'><br>";
  html += "Port: <input name='port' value='" + String(mqttPort) + "' "
          "title='Standardmäßig 1883. Passe den Port an, falls dein Broker einen anderen verwendet.'><br>";
  html += "Benutzer: <input name='user' value='" + String(mqttUser) + "' "
          "title='Benutzername für die Verbindung zum MQTT-Server (optional)'><br>";
  html += "Passwort: <input type='password' name='pass' value='" + String(mqttPassword) + "' "
          "title='Passwort für den oben angegebenen Benutzer (optional)'><br>";
  html += "<input type='submit' value='MQTT-Verbindung speichern'></form>";
  html += "<form id='discoveryPrefixForm' method='POST' action='/mqttdiscoveryprefix'>";
  html += "<p><strong>MQTT Discovery Prefix</strong>:</p>";
  html += "<input name='mqtt_discovery_prefix' value='" + mqttDiscoveryPrefix + "' "
          "title='Prefix für MQTT Auto-Discovery, z. B. homeassistant/'><br>";
  html += "<input type='submit' value='Discovery-Prefix speichern'>";
  html += "</form>";
  html += "<form id='mqttTopicsForm' method='POST' action='/mqtttopics'>";
  html += "<p><strong>MQTT-Prefix</strong> für alle ausgehenden Nachrichten:</p>";
  html += "Publish-Prefix: <input name='mqtt_pub_prefix' value='" + mqttPublishPrefix + "' "
          "title='Dieses Präfix wird für alle automatisch gesendeten MQTT-Nachrichten verwendet, z. B. esp32/innen/. Achte auf einen abschließenden Slash!'><br>";
  html += "<p><strong>Abonnierte MQTT-Topics</strong> für empfangene Sensordaten:</p>";
  html += "Innen Temperatur: <input name='temp_innen' value='" + mqttTempInnen + "' "
          "title='MQTT-Topic, von dem Temperaturwerte (in °C) für den Innenraum empfangen werden. Nur bei MQTT-Modus aktiv.'><br>";
  html += "Innen Feuchte: <input name='hygro_innen' value='" + mqttHygroInnen + "' "
          "title='MQTT-Topic, von dem Luftfeuchtigkeit (0–100 %) für den Innenraum empfangen wird.'><br>";
  html += "Außen Temperatur: <input name='temp_aussen' value='" + mqttTempAussen + "' "
          "title='MQTT-Topic, von dem Temperaturwerte für den Außenbereich empfangen werden.'><br>";
  html += "Außen Feuchte: <input name='hygro_aussen' value='" + mqttHygroAussen + "' "
          "title='MQTT-Topic, von dem Luftfeuchtigkeit für den Außenbereich empfangen wird.'><br>";
  html += "<input type='submit' value='MQTT Topics speichern'></form>";
  html += "<form id='discoveryForm' method='POST' action='/mqttdiscovery'>";
  html += "<input type='submit' value='MQTT Discovery erneut senden'>";
  html += "</form>";
  html += "</fieldset>";

  html += "<fieldset><legend>Hostname</legend>";
  html += "<form id='hostnameForm' method='POST' action='/hostname'>";
  html += "Gerätename im Netzwerk (Hostname): <input name='hostname' value='" + hostname + "' "
          "title='Dieser Name wird z. B. für mDNS (taupunktlueftung.local) verwendet. Achtung: Nach Änderung ist das Webinterface evtl. nur noch unter der neuen Adresse (oder über die IP-Adresse) erreichbar!' style='display:inline-block; width:auto;'><span style='margin-left:8px; color:gray;'>IP: " + WiFi.localIP().toString() + "</span><br>";
  html += "<p style='font-size:0.9em;'>Nach Änderung ist das Webinterface unter dem neuen Namen erreichbar (z. B. <code>http://neuername.local</code>).</p>";
  html += "<input type='submit' value='Hostname speichern'>";
  html += "</form></fieldset>";

  html += "<fieldset><legend>Zugang (Login)</legend>";
  html += "<form id='benutzernameForm' onsubmit='return submitBenutzernameForm(event);'>";
  html += "Benutzername: <input type='text' id='user_neu' name='neuer_benutzername' value='" + String(configUsername) + "' autocomplete='username' "
          "title='Anmeldename für den Zugriff auf das gesamte Webinterface (HTTP-Basic-Auth). Nach dem Ändern fragt der Browser sofort neu nach den Zugangsdaten.'><br>";
  html += "<input type='submit' value='Benutzername ändern'>";
  html += "</form>";
  html += "<form id='passwortForm' onsubmit='return submitPasswortForm(event);'>";
  html += "Neues Passwort: <input type='password' id='pw_neu' name='neues_passwort' autocomplete='new-password' "
          "title='Neues Passwort für den Webinterface-Login. Da die Übertragung unverschlüsselt (HTTP) erfolgt, bitte ein Passwort wählen, das nicht anderswo wiederverwendet wird.'><br>";
  html += "Bestätigen: <input type='password' id='pw_bestaetigen' name='passwort_bestaetigen' autocomplete='new-password' title='Zur Kontrolle das neue Passwort erneut eingeben.'><br>";
  html += "<input type='submit' value='Passwort ändern'>";
  html += "</form></fieldset>";

  html += "<fieldset><legend>Firmware</legend>";
  html += "<p><button type='button' onclick=\"showTab('settings'); setTimeout(openFirmwareModalUI, 100);\">Firmware-Update</button>";
  html += "<a class='button-link' href='/firmwarebackup' download>Aktuelle Firmware sichern (Download)</a></p>";
  html += "</fieldset>";

  html += "<fieldset><legend>Gerät</legend>";
  html += "<p><button type='button' onclick='rebootDevice()'>Gerät neu starten</button></p>";
  html += "<p><button type='button' onclick='wifiResetDevice()' title='Löscht nur die gespeicherten WLAN-Zugangsdaten, alle anderen Einstellungen bleiben erhalten.'>WLAN neu konfigurieren</button></p>";
  html += "<p style='font-size:0.9em; color:gray;'>Löscht nur die gespeicherten WLAN-Zugangsdaten (alle anderen Einstellungen bleiben erhalten) und startet neu. "
          "Danach mit einem Smartphone/PC mit dem Netz „TaupunktLueftung-Setup“ verbinden, um ein neues WLAN einzurichten – wie bei der Ersteinrichtung.</p>";
  html += "</fieldset>";

  // Debug-Ausgabe: Master-Toggle blendet die Kategorien + Log-Anzeige ein.
  // Bewusst nur die Kategorien, die tatsächlich auftreten können, während
  // diese Seite offen ist (kein Boot-/WLAN-Verbindungsablauf, keine Firmware-
  // Update-Ereignisse - während eines Updates ersetzt das JS die komplette
  // Seite durch die Wartemeldung, das Debug-Panel wäre währenddessen ohnehin
  // nicht sichtbar).
  html += "<fieldset><legend>Debug</legend>";
  html += "<form id='debugForm' onchange='submitDebugSettings()'>";
  html += "<label title='Zeigt laufend aktualisierte Diagnose-Meldungen direkt hier im Browser an, ohne USB-Kabel/seriellen Monitor.'>"
          "<input type='checkbox' id='debug_aktiv' name='debug_aktiv'";
  html += debugModusAktiv ? " checked" : "";
  html += "> Debugmodus aktivieren</label><br>";
  html += "<div id='debugKategorien' class='" + String(debugModusAktiv ? "" : "hidden") + "' style='margin:8px 0;'>";
  struct { const char* id; const char* label; bool aktiv; const char* hinweis; } kategorien[] = {
    {"kat_sensor", "Sensor", debugKatSensor, "Re-Init-Versuche und NAN-Fehler bei den Sensoren."},
    {"kat_mqtt", "MQTT", debugKatMqtt, "Empfangene Nachrichten, Verbindungsversuche, Discovery-Status."},
    {"kat_chartdata", "Chartdata", debugKatChartdata, "Zeitmessung und Heap-Verbrauch bei jedem Chart-Abruf."},
    {"kat_diag", "Diag", debugKatDiag, "Periodischer Heap-/WLAN-Status, alle 60 Sekunden."},
    {"kat_auth", "Auth", debugKatAuth, "Fehlgeschlagene Login-Versuche inkl. IP-Adresse."}
  };
  for (auto &k : kategorien) {
    html += "<label style='margin-right:14px;' title='" + String(k.hinweis) + "'>"
            "<input type='checkbox' name='" + String(k.id) + "'";
    if (k.aktiv) html += " checked";
    html += "> " + String(k.label) + "</label>";
  }
  html += "</div>";
  html += "</form>";
  html += "<p class='" + String(debugModusAktiv ? "" : "hidden") + "' id='debugLeerenWrap'>"
          "<button type='button' onclick='leereDebugAusgabe()'>Ausgabe leeren</button></p>";
  html += "<pre id='debugAusgabe' class='" + String(debugModusAktiv ? "" : "hidden") + "' "
          "style='max-height:240px; overflow-y:auto; background:var(--input-bg); border:1px solid var(--border); "
          "padding:8px; font-size:0.85em; white-space:pre-wrap;'></pre>";
  html += "</fieldset>";

  html += "<p align='center'>";
  html += "<a href='https://github.com/mallewski/TaupunktLueftung' target='_blank' "
        "style='display:inline-block;text-decoration:none;padding:6px 12px;"
        "background:#24292e;color:white;border-radius:5px;font-weight:bold;'>"
        "<svg height='16' width='16' viewBox='0 0 16 16' fill='white' "
        "style='vertical-align:middle;margin-right:6px;'>"
        "<path d='M8 0C3.58 0 0 3.58 0 8c0 3.54 2.29 6.53 5.47 7.59.4.07.55-.17.55-.38"
        " 0-.19-.01-.82-.01-1.49-2.01.37-2.53-.49-2.69-.94-.09-.23-.48-.94-.82-1.13"
        "-.28-.15-.68-.52-.01-.53.63-.01 1.08.58 1.23.82.72 1.21 1.87.87 2.33.66.07"
        "-.52.28-.87.51-1.07-1.78-.2-3.64-.89-3.64-3.95 0-.87.31-1.59.82-2.15-.08"
        "-.2-.36-1.02.08-2.12 0 0 .67-.21 2.2.82.64-.18 1.32-.27 2-.27s1.36.09 2 .27"
        "c1.53-1.04 2.2-.82 2.2-.82.44 1.1.16 1.92.08 2.12.51.56.82 1.27.82 2.15"
        " 0 3.07-1.87 3.75-3.65 3.95.29.25.54.73.54 1.48 0 1.07-.01 1.93-.01 2.2"
        " 0 .21.15.46.55.38A8.013 8.013 0 0 0 16 8c0-4.42-3.58-8-8-8z'/>"
        "</svg> Projekt auf GitHub</a>";
  html += "</p>";
  html += "<p align='center'>Wenn du dieses Projekt nützlich findest, kannst du mir einen Kaffee spendieren:</p>";
  html += "<p align='center'><a href='https://www.buymeacoffee.com/mallewski' target='_blank'><img src='https://cdn.buymeacoffee.com/buttons/v2/default-yellow.png' alt='Buy Me A Coffee' height='60' width='217'></a></p>";

  html += "</div>";
  return html;
}

String getFirmwareModalHtml() {
  String html = R"rawliteral(
    <div id="firmwareModal" class="modal hidden">
      <div class="modal-content">
        <span class="close" onclick="closeFirmwareModal()">&times;</span>
        <h3>Firmware-Update durchführen</h3>
  )rawliteral";

  html += "<p>Installierte Firmware-Version: " + String(FIRMWARE_VERSION) + "</p>";

  html += R"rawliteral(
        <form id="firmwareUploadForm" method="POST" action="/update" enctype="multipart/form-data" onsubmit="return submitFirmwareUpdate(event);">
          <input type="file" name="firmware" required><br><br>
          <input type="submit" value="Upload & Update">
        </form>
      </div>
    </div>
  )rawliteral";

  return html;
}

//Handler
void handleTempSchutz() {
  if (server.hasArg("aktiv")) {
    schutzVorAuskuehlungAktiv = true;
  } else {
    schutzVorAuskuehlungAktiv = false;
  }
  if (server.hasArg("min_temp")) {
    minTempInnen = server.arg("min_temp").toFloat();
  }

  prefs.begin("config", false);
  prefs.putBool("tempschutz", schutzVorAuskuehlungAktiv);
  prefs.putFloat("min_temp", minTempInnen);
  prefs.end();

  redirectToSettings();
}

void handleAustrocknungsschutz() {
  schutzVorAustrocknungAktiv = server.hasArg("aktiv");
  if (server.hasArg("min_rh")) {
    minFeuchteInnen = server.arg("min_rh").toFloat();
  }

  prefs.begin("config", false);
  prefs.putBool("austrocknungsschutz", schutzVorAustrocknungAktiv);
  prefs.putFloat("min_rh", minFeuchteInnen);
  prefs.end();

  server.send(200, "text/plain", "OK");
}

void handleFeuchteregelung() {
  konstanteFeuchteAktiv = server.hasArg("aktiv");
  if (server.hasArg("ziel_rh")) zielFeuchteInnen = server.arg("ziel_rh").toFloat();
  if (server.hasArg("hysterese")) hysterese = server.arg("hysterese").toFloat();

  prefs.begin("config", false);
  prefs.putBool("feuchte_regelung", konstanteFeuchteAktiv);
  prefs.putFloat("ziel_rh", zielFeuchteInnen);
  prefs.putFloat("hysterese", hysterese);
  prefs.end();

  server.send(200, "text/plain", "OK");
}

void handleSetSchwelle() {
  if (server.hasArg("schwelle")) {
    taupunktDifferenzSchwellwert = server.arg("schwelle").toFloat();
    prefs.begin("config", false);
    prefs.putFloat("schwelle", taupunktDifferenzSchwellwert);
    prefs.end();
  }
  redirectToSettings();
}

void handleTimerSettings() {
  if (server.hasArg("laufzeit")) {
    mindestLaufzeit_ms = server.arg("laufzeit").toInt() * 60 * 1000;
  }
  if (server.hasArg("pause")) {
    mindestPause_ms = server.arg("pause").toInt() * 60 * 1000;
  }

  prefs.begin("config", false);
  prefs.putUInt("min_laufzeit", mindestLaufzeit_ms / 60000);
  prefs.putUInt("min_pause", mindestPause_ms / 60000);
  prefs.end();

  redirectToSettings();
}

// Sensorquelle (Hardware/MQTT) - Sensortyp DHT22/SHT31 ist wieder Compile-Zeit-Sache
void handleSetModus() {
  if (server.hasArg("modus_innen")) modus_innen = server.arg("modus_innen");
  if (server.hasArg("modus_aussen")) modus_aussen = server.arg("modus_aussen");
  prefs.begin("config", false);
  prefs.putString("modus_innen", modus_innen);
  prefs.putString("modus_aussen", modus_aussen);
  prefs.end();
  redirectToSettings();
}

void handleSetMQTT() {
  if (server.hasArg("mqtt")) {
    if (debugMQTT) {
      Serial.println("MQTT-Toggle empfangen: " + server.arg("mqtt"));
    }
    mqttAktiv = (server.arg("mqtt") == "MQTT aktivieren");
    prefs.begin("config", false);
    prefs.putBool("mqtt", mqttAktiv);
    prefs.end();
    if (mqttAktiv) {
      reconnectMQTT();
    }
  }
  redirectToSettings();
}

void handleMQTTConfig() {
  if (server.hasArg("server")) server.arg("server").toCharArray(mqttServer, sizeof(mqttServer));
  if (server.hasArg("port")) mqttPort = server.arg("port").toInt();
  if (server.hasArg("user")) server.arg("user").toCharArray(mqttUser, sizeof(mqttUser));
  if (server.hasArg("pass")) server.arg("pass").toCharArray(mqttPassword, sizeof(mqttPassword));

  saveMQTTSettings();
  mqttClient.setServer(mqttServer, mqttPort);
  reconnectMQTT();

  redirectToSettings();
}

void handleMQTTTopics() {
  mqttTempInnen   = server.arg("temp_innen");
  mqttHygroInnen  = server.arg("hygro_innen");
  mqttTempAussen  = server.arg("temp_aussen");
  mqttHygroAussen = server.arg("hygro_aussen");

  if (server.hasArg("mqtt_pub_prefix")) {
    mqttPublishPrefix = server.arg("mqtt_pub_prefix");
    if (!mqttPublishPrefix.endsWith("/")) mqttPublishPrefix += "/";
  }

  saveMQTTTopics();
  if (mqttClient.connected()) {
    resubscribeMQTTTopics();
    publishMQTTDiscovery();
  }

  redirectToSettings();
}

void handleMQTTDiscovery() {
  if (mqttClient.connected()) {
    publishMQTTDiscovery();
    Serial.println("MQTT ist verbunden. Sende Discovery...");
    debugPush(KAT_MQTT, "MQTT ist verbunden. Sende Discovery...");
  } else {
    Serial.println("MQTT NICHT verbunden – keine Discovery gesendet.");
    debugPush(KAT_MQTT, "MQTT NICHT verbunden - keine Discovery gesendet.");
  }
  redirectToSettings();
}

// Liefert den aktuellen Ringpuffer-Inhalt als reinen Text, neueste Zeile
// zuerst. Kein JSON nötig - wird direkt in ein <pre>/<textarea> auf der
// Einstellungsseite geschrieben.
void handleDebugLog() {
  String out;
  if (!debugModusAktiv) {
    out = "(Debugmodus ist deaktiviert)";
  } else if (debugPufferAnzahl == 0) {
    out = "(Noch keine Einträge - passende Kategorie aktiv und warten, bis etwas passiert)";
  } else {
    for (int i = 0; i < debugPufferAnzahl; i++) {
      int idx = (debugPufferIndex - 1 - i + DEBUG_PUFFER_ZEILEN * 2) % DEBUG_PUFFER_ZEILEN;
      out += debugPuffer[idx] + "\n";
    }
  }
  server.send(200, "text/plain", out);
}

// Setzt Debugmodus + Kategorien anhand der übermittelten Checkbox-Werte.
// Bewusst nicht in NVS gespeichert: reine Laufzeit-Diagnoseeinstellung, soll
// nach einem Neustart nicht "vergessen aktiv" bleiben.
void handleDebugSettings() {
  debugModusAktiv = server.hasArg("debug_aktiv");
  debugKatSensor = server.hasArg("kat_sensor");
  debugKatMqtt = server.hasArg("kat_mqtt");
  debugKatChartdata = server.hasArg("kat_chartdata");
  debugKatDiag = server.hasArg("kat_diag");
  debugKatAuth = server.hasArg("kat_auth");
  server.send(200, "text/plain", "OK");
}

// Setzt den Ringpuffer zurück - die alten Zeilen bleiben zwar bis zum
// Überschreiben noch im RAM stehen, werden aber nicht mehr ausgegeben. So
// zeigt der nächste Poll sofort einen leeren Stand, statt die alten Einträge
// nach dem Klick gleich wieder anzuzeigen.
void handleDebugClear() {
  debugPufferAnzahl = 0;
  debugPufferIndex = 0;
  server.send(200, "text/plain", "OK");
}


void handleHostnameUpdate() {
  if (server.hasArg("hostname")) {
    String newName = server.arg("hostname");
    newName.trim();
    if (newName.length() > 0) {
      hostname = newName;
      prefs.begin("config", false);
      prefs.putString("hostname", hostname);
      prefs.end();
      WiFi.setHostname(hostname.c_str());
      MDNS.end();
      MDNS.begin(hostname.c_str());
      Serial.println("Hostname geändert auf: " + hostname);
    }
  }

  String newHost = hostname;
  String ip = WiFi.localIP().toString();

  String html = "<!DOCTYPE html><html><head><meta charset='UTF-8'>";
  html += "<meta http-equiv='refresh' content='15;url=http://" + newHost + ".local'>";
  html += "<title>Hostname geändert</title></head><body>";
  html += "<h3>Hostname gespeichert: <code>" + newHost + "</code></h3>";
  html += "<p>Das Webinterface sollte bald unter <a href='http://" + newHost + ".local'>http://" + newHost + ".local</a> erreichbar sein.</p>";
  html += "<p>Alternativ erreichst du es per IP: <code>http://" + ip + "</code></p>";
  html += "<p>Kein Neustart nötig – Änderung wird beim nächsten WLAN-Connect aktiv.</p>";
  html += "</body></html>";

  server.send(200, "text/html", html);
}

void handleSetUsername() {
  String neu = server.hasArg("neuer_benutzername") ? server.arg("neuer_benutzername") : "";
  neu.trim();

  if (neu.length() == 0) {
    server.send(400, "text/plain", "Benutzername darf nicht leer sein.");
    return;
  }
  if (neu.length() >= sizeof(configUsername)) {
    server.send(400, "text/plain", "Benutzername zu lang (max. 31 Zeichen).");
    return;
  }

  neu.toCharArray(configUsername, sizeof(configUsername));
  prefs.begin("config", false);
  prefs.putString("web_user", neu);
  prefs.end();

  Serial.println("Webinterface-Benutzername geändert auf: " + neu);
  server.send(200, "text/plain", "OK");
}

void handleSetPassword() {
  String neu = server.hasArg("neues_passwort") ? server.arg("neues_passwort") : "";
  String bestaetigung = server.hasArg("passwort_bestaetigen") ? server.arg("passwort_bestaetigen") : "";

  if (neu.length() == 0) {
    server.send(400, "text/plain", "Passwort darf nicht leer sein.");
    return;
  }
  if (neu.length() >= sizeof(configPassword)) {
    server.send(400, "text/plain", "Passwort zu lang (max. 63 Zeichen).");
    return;
  }
  if (neu != bestaetigung) {
    server.send(400, "text/plain", "Passwörter stimmen nicht überein.");
    return;
  }

  neu.toCharArray(configPassword, sizeof(configPassword));
  prefs.begin("config", false);
  prefs.putString("web_pass", neu);
  prefs.end();

  Serial.println("Webinterface-Passwort geändert");
  server.send(200, "text/plain", "OK");
}

void handleFirmwareUpload() {
  HTTPUpload& upload = server.upload();

  if (upload.status == UPLOAD_FILE_START) {
    firmwareUploadAuthorized = server.authenticate(configUsername, configPassword);
    if (!firmwareUploadAuthorized) {
      Serial.println("Firmware-Upload abgelehnt: keine gültige Authentifizierung.");
      return;
    }
    prepareForFirmwareUpdate();
    firmwareUpdateSuccess = false;
    Serial.printf("Update: %s\n", upload.filename.c_str());
    if (!Update.begin()) {
      Update.printError(Serial);
    }
  } else if (upload.status == UPLOAD_FILE_WRITE) {
    if (!firmwareUploadAuthorized) return;
    if (Update.write(upload.buf, upload.currentSize) != upload.currentSize) {
      Update.printError(Serial);
    }
  } else if (upload.status == UPLOAD_FILE_END) {
    if (!firmwareUploadAuthorized) return;
    if (Update.end(true)) {
      Serial.printf("Update abgeschlossen: %u Bytes\n", upload.totalSize);
      firmwareUpdateSuccess = true;
    } else {
      Update.printError(Serial);
      firmwareUpdateSuccess = false;
    }
  }
}

void prepareForFirmwareUpdate() {
  mqttAktivVorUpdate = mqttAktiv;
  mqttClient.disconnect();
  mqttAktiv = false;
  updateModeActive = true;
  Serial.println("Firmware-Update vorbereitet. Dienste deaktiviert.");
}

void handleFirmwareBackup() {
  const esp_partition_t* running = esp_ota_get_running_partition();
  if (!running) {
    server.send(500, "text/plain", "Konnte laufende Partition nicht ermitteln.");
    return;
  }

  size_t size = running->size;
  String filename = "TaupunktLueftung_" + String(FIRMWARE_VERSION) + "_backup.bin";

  server.sendHeader("Content-Disposition", "attachment; filename=\"" + filename + "\"");
  server.setContentLength(size);
  server.send(200, "application/octet-stream", "");

  const size_t CHUNK = 1024;
  uint8_t buf[CHUNK];
  size_t offset = 0;

  while (offset < size) {
    size_t toRead = min(CHUNK, size - offset);
    esp_err_t err = esp_partition_read(running, offset, buf, toRead);
    if (err != ESP_OK) {
      Serial.println("Fehler beim Lesen der Partition bei Offset " + String(offset));
      break;
    }
    server.sendContent((const char*)buf, toRead);
    offset += toRead;
  }

  Serial.println("Firmware-Backup heruntergeladen (" + String(size) + " Bytes)");
}

// --- Setup --->
// Der ESP32-WLAN-Treiber setzt den Modem-Sleep-Modus bei jedem (Re-)Verbin-
// dungsaufbau auf seinen Standard (aktiviert) zurück - nicht nur beim ersten
// Verbinden über WiFiManager, sondern auch bei jeder automatischen
// Wiederverbindung im laufenden Betrieb (z. B. nach einem kurzen WLAN-
// Aussetzer bei schwachem Signal). Dieser Event-Handler setzt setSleep(false)
// deshalb bei jeder erfolgreichen Verbindung erneut, statt sich nur auf den
// einmaligen Aufruf direkt nach dem Setup zu verlassen.
void onWifiVerbunden(WiFiEvent_t event, WiFiEventInfo_t info) {
  WiFi.setSleep(false);
}

void setupWiFi() {
  prefs.begin("config", true);
  hostname = prefs.getString("hostname", DEFAULT_HOSTNAME);
  prefs.end();
  if (hostname.isEmpty()) hostname = DEFAULT_HOSTNAME;

  WiFi.mode(WIFI_STA);
  WiFi.onEvent(onWifiVerbunden, ARDUINO_EVENT_WIFI_STA_GOT_IP);
  WiFi.setHostname(hostname.c_str());

  esp_netif_t* sta_netif = esp_netif_get_handle_from_ifkey("WIFI_STA_DEF");
  if (sta_netif) {
    esp_netif_set_hostname(sta_netif, hostname.c_str());
  }

  WiFiManager wm;
  wm.setDebugOutput(false);
  wm.setTimeout(180);
  char hb[33];
  hostname.toCharArray(hb, sizeof(hb));
  WiFiManagerParameter custom_hn("hn", "Hostname", hb, 32);
  wm.addParameter(&custom_hn);

  if (!wm.autoConnect("TaupunktLueftung-Setup")) {
    Serial.println("Kein WLAN – Offline-Modus");
    return;
  }

  // WiFi.setSleep(false) MUSS erst hier, NACH wm.autoConnect(), gesetzt
  // werden: WiFiManager baut die eigentliche WLAN-Verbindung intern selbst
  // auf (eigene WiFi.begin()-Aufrufe, ggf. mehrere Verbindungsversuche/Scans)
  // und der ESP32-WLAN-Treiber setzt den Modem-Sleep-Modus bei jedem
  // (Re-)Verbindungsaufbau auf seinen Standard (aktiviert) zurück. Ein Aufruf
  // vor autoConnect() wird dadurch wirkungslos überschrieben - das dürfte der
  // Grund sein, warum sich an der Erreichbarkeit trotz des Aufrufs zuvor
  // nichts geändert hat.
  WiFi.setSleep(false);

  hostname = custom_hn.getValue();
  hostname.trim();
  if (hostname.isEmpty()) hostname = DEFAULT_HOSTNAME;
  prefs.begin("config", false);
  prefs.putString("hostname", hostname);
  prefs.end();

  if (sta_netif) {
    esp_netif_set_hostname(sta_netif, hostname.c_str());
  }

  if (!MDNS.begin(hostname.c_str())) {
    Serial.println("mDNS start failed");
  } else {
    Serial.printf("mDNS: http://%s.local\n", hostname.c_str());
  }
}

// Sensor-Setup: Sensortyp außen ist wieder eine reine Compile-Zeit-Entscheidung
// über #define SENSOR_TYP_AUSSEN_SHT31 - nur die tatsächlich benötigte
// Bibliothek (DHT ODER SHT31 für außen) wird dadurch überhaupt eingebunden.
void setupSensoren() {
  Wire.begin();
  Wire.setTimeOut(100); // verhindert unbegrenztes Blockieren des loop() bei I2C-Bushängern
  pinMode(RELAY_LED_PIN, OUTPUT);
  pinMode(STATUS_GREEN_PIN, OUTPUT);
  pinMode(STATUS_RED_PIN, OUTPUT);
  pinMode(STATUS_YELLOW_PIN, OUTPUT);
  setLEDs(false, false, false);

  shtInnen.begin(0x44);
#ifdef SENSOR_TYP_AUSSEN_SHT31
  shtAussen.begin(0x45);
#else
  dht.begin();
#endif
}
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
void loop() {
  if (updateModeActive) {
    server.handleClient();
    return;
  }

  static unsigned long lastBlink = 0;
  static bool ledState = false;

  if (sensorFehlerInnen || sensorFehlerAussen) {
    if (millis() - lastBlink > 500) {
      lastBlink = millis();
      ledState = !ledState;
      digitalWrite(STATUS_GREEN_PIN, LOW);
      digitalWrite(STATUS_YELLOW_PIN, LOW);
      digitalWrite(STATUS_RED_PIN, ledState);
    }

    handleMQTT();
    handleWebServer();
    handleSensorzyklus();
    handleWiFiReconnect();
    handleDiagnoseLog();
    return;
  }

  handleMQTT();
  handleWebServer();
  handleSensorzyklus();
  handleWiFiReconnect();
  handleDiagnoseLog();
}
