mallewski/TaupunktLueftung/(commit log)

2025-04-03 Neustrukturierung und Modularisierung der gesamten TaupunktLueftung.ino
2025-05-05 Austrocknungsschutz und Feuchteregelungsmodus ergänzt
2025-05-06 SHT31 als neuen Standard für SensorAußen
2025-05-09 led zuordnung im Feuchteregelmodus angepasst
2025-05-09 mdns und hostaname ergänzt
2025-05-11 Hostname konfigurierbar und MQTT optimiert (offline wird jetzt erkannt)
2025-05-11 Fehleranzeige und -behandlung ergänzt
2026-08-30 add reboot button
2026-08-31 fix handleReboot function
    Removed handleReboot function that handled server reboot.
    [TaupunktLueftung.ino]
2026-08-31 feat: Reboot-Button, Firmware-Backup, mehrstufige Historie und Bugfixes (v3.7)
    feat: Reboot-Button, Firmware-Backup, mehrstufige Historie und Bugfixes (v3.7)
    Neue Funktionen:
    - Reboot-Button im Web-Interface (POST /reboot) mit Bestätigungsdialog
    und automatischem Reload sobald das Gerät wieder erreichbar ist
    - Firmware-Backup: laufende Partition kann als .bin heruntergeladen
    werden (GET /firmwarebackup), bevor ein neues Update aufgespielt wird
    - Firmware-Update mit echter Erfolgsprüfung: bei fehlgeschlagenem
    Update kein Neustart mehr, sondern Rollback (MQTT/Sensorik werden
    wiederhergestellt) und ehrliche Fehlermeldung im Interface
    - Mehrstufige Chart-Historie (RAM-Ringp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
    [TaupunktLueftung.ino]
2026-09-03 feat: Sensortyp außen (DHT22/SHT31) zur Laufzeit umschaltbar (v3.8)
    Der Außensensor-Typ war bisher nur über einen Compiler-Schalter
    (#define SENSOR_TYP_AUSSEN_SHT31) zur Compile-Zeit festlegbar. Das
    führte dazu, dass ein Firmware-Update aus einem abweichenden
    Repository-Stand den aktiven Sensortyp unbemerkt ändern konnte, ohne
    dass sich an der Verkabelung etwas geändert hatte (Ursache für NaN-
    Werte nach dem letzten Update).
    Änderungen:
    - Beide Sensor-Objekte (SHT31 und DHT22) werden jetzt immer
    initialisiert; die Auswahl erfolgt zur Laufzeit über die neue
    Variable sensorTypAussen ("dht22" / "sht31")
    - Neues Dropdown "Sensortyp außen" im Bereich Sensorquelle der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
2026-09-03 fix: Boot-Reihenfolge und Reboot-Schutz für Relais-Timer (v3.8.1)
    Bugfixes:
    - setup(): setupPreferences() wird jetzt vor setupSensoren() aufgerufen.
    Vorher lief die Sensor-Initialisierung bereits, bevor
    sensorTypAussen aus den Preferences geladen war - der Lazy-Init für
    SHT31/DHT22 griff dadurch nie auf den tatsächlich gespeicherten Wert
    zu, sondern immer auf den Compile-Zeit-Default ("dht22").
    - setupPreferences(): letzteAktivierung/letzteDeaktivierung werden
    beim Boot jetzt konservativ auf "gerade jetzt" statt "bereits
    abgelaufen" gesetzt. Dadurch muss nach jedem Neustart - egal ob
    geplant oder durch einen Spannungseinbruch beim Relaisschalten
    ausgelöst - er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
    [TaupunktLueftung.ino]
2026-09-03 Enhance web interface security and sensor handling
    - Added authentication for web interface and improved sensor reinitialization logic.
    - Set chart update mode to 'none' to eliminate flicker/initial animation on refresh
    - Standardized y-axis scaling for status chart to discrete 0/1 steps (OFF/ON)
    - Added dynamic background color mapping for status bar updates
    - Preserved current partition setup for NVS data persistence during OTA updates
2026-09-04 feat: Auth, Fail-Safe, Settings-Überarbeitung und WLAN-Reset (v4.0)
    - Fail-Safe bei Sensorausfall: Lüftung schaltet nach 15s durchgängigem
    Sensorfehler zwangsweise ab, statt unbegrenzt im letzten Zustand zu
    verharren (vorher: einfaches "return", Relais blieb unbegrenzt aktiv)
    - Speicher-Refactor: handleRoot(), getSettingsHtml(), CSS und Haupt-JS
    laufen jetzt aus PROGMEM/chunked Streaming statt als große Strings im
    RAM; %SCHWELLE%-Server-Replace durch Live-Feld in /livedata ersetzt
    - HTTP-Basic-Auth für das gesamte Webinterface (außer /style.css),
    inklusive Firmware-Upload
    - Benutzername und Passwort für den Login über die Einstellungen
    änderbar, persistiert in N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
    [TaupunktLueftung.ino]
2026-09-05 Add matrix strategy for sensor variant builds
2026-09-05 Update release-build.yml for sensor type handling
2026-09-05 Update debug_hinweise.md with additional troubleshooting info
    Added notes on MQTT Discovery, web interface authentication, and sensor issues. Included instructions for erasing NVS.
2026-09-05 Expand quick start guide with setup instructions
    Added detailed setup instructions for Arduino IDE, project preparation, sensor configuration, hardware setup, and initial flashing process for the ESP32.
2026-09-05 Revise README for login details and power supply info
    Updated default login credentials and added warning for unchanged credentials. Enhanced explanation for ESP32 power supply considerations.
2026-09-05 feat: Dark-Mode, SHT31 als neuer Default, Warnhinweis bei Standard-Login (v4.2)
    - Dark Mode (Hell/Dunkel/System) über CSS-Variablen; "System" wird per JS
    einmalig in "light"/"dark" aufgelöst statt als dritte CSS-Definition
    dupliziert zu werden. Lebt komplett im Browser (localStorage), kein
    zusätzlicher RAM-/NVS-Verbrauch auf dem ESP32.
    - Dunkel-Palette überarbeitet: kein reines Schwarz/Weiß mehr, angelehnt an
    etablierte Dark-Themes für bessere Lesbarkeit.
    - Chart.js-Diagramme übernehmen jetzt ebenfalls die Theme-Farben
    (Achsen, Legende, Gitterlinien, Canvas-Hintergrund), live umschaltbar
    ohne Reload.
    - MQTT-Ein/Aus-Schalter zurück in den Bereich "Se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
2026-09-05 Enhance firmware update process with confirmation and feedback
    Refactor firmware update confirmation and submission process to improve user experience and error handling.
    [TaupunktLueftung.ino]
2026-09-06 fix: blockierenden MQTT-Reconnect entschärft
    reconnectMQTT() blockierte bei nicht erreichbarem Broker
    bislang bei jedem loop()-Durchlauf erneut für die Dauer eines Verbindungs-
    versuchs und legte damit auch den Webserver lahm - jetzt gedrosselt auf
    einen Versuch alle 5 Sekunden (MQTT_RECONNECT_INTERVAL_MS) und mit kurzem
    Socket-Timeout (2s statt 15s Default), damit ein einzelner Versuch schneller
    aufgibt.
    [TaupunktLueftung.ino]
2026-09-07 fix: Diagramme auf schmalen Bildschirmen lesbar gemacht
    Canvas-Höhen kamen bisher aus festen width/height-Attributen, deren
    Seitenverhältnis Chart.js auch auf schmalen Handy-Displays beibehalten
    hat - der AN/AUS-Chart schrumpfte dadurch auf ca. 25px und zeigte nur
    noch "AUS" in der Achse. Feste Pixelhöhen über ein Wrapper-Div plus
    maintainAspectRatio:false lösen das unabhängig von der Bildschirmbreite.
    fix: fehlende Null-Terminierung und zu kleinen MQTT-Puffer behoben
    strncpy() garantierte keine Null-Terminierung von mqttServer/mqttUser/
    mqttPassword und dem Hostname-Puffer, wenn die Eingabe die Puffergröße
    erreicht - jetzt wie schon bei configUsername/configPassword über
    toCharAr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
    [TaupunktLueftung.ino]
2026-09-07 Add max values for temperature and humidity tracking
2026-09-08 fix: Zeitraum-Speicherung wiederhergestellt, Zickzack in Charts durch verlustfreie Anzeige-Verdichtung behoben
    - Zeitraum-Auswahl (rangeSelector) wird wieder korrekt in localStorage
    gespeichert und vor dem ersten Chart-Aufbau wiederhergestellt. War in
    einem vorherigen Commit versehentlich durch einen älteren Zwischenstand
    überschrieben worden.
    - Neue Funktion verdichteFuerAnzeige(): reduziert bei Bedarf die Anzahl
    der zu zeichnenden Punkte auf max. 300 (MAX_CHART_POINTS), bevor Chart.js
    sie rendert. Verhindert das "wilde Zickzack" in Ansichten mit sehr vielen
    Rohpunkten (z. B. 1440 Punkte in der 24h-Ansicht auf wenige hundert
    Bildschirm-Pixel).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
    [TaupunktLueftung.ino]
2026-09-08 Enhance form submission error handling and remove unused code
    [TaupunktLueftung.ino]
2026-09-24 fix: add periodic WiFi reconnect attempts in loop()
    Previously wm.autoConnect() was only called once during setup(). If that
    single connection attempt failed (e.g. because the router hadn't finished
    rebooting yet after a shared power outage while the ESP32 had already
    booted), the device stayed offline forever - the control logic kept
    running normally (it doesn't depend on WiFi), but the web interface
    became permanently unreachable with no further automatic retry.
    Adds handleWiFiReconnect(), called from both loop() branches: checks
    WiFi.status() every iteration (cheap, no-op if already connected), and
    only when disconnected, attempts WiFi.reconnect() throttled to once every
    30s - same patte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
    [TaupunktLueftung.ino]
2026-10-14 Fix duplicate SHT31 sensor description in README
    Removed duplicate description of the SHT31 sensor and added a caution about cable length.
